maxim5858mru/graduate-work-college-tiu/Altium Designer Project/Source/AMS1117 - 3.3 PCB.jpg

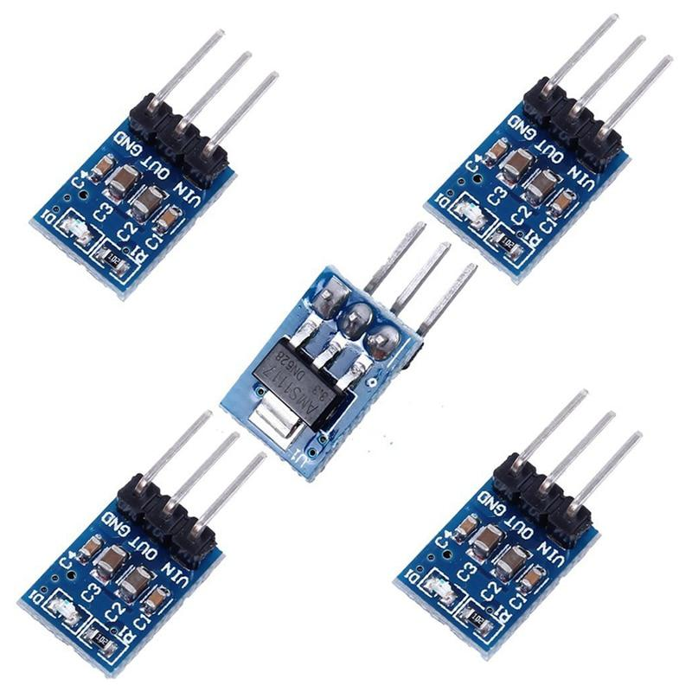
Altium Designer Project/Source/AMS1117 - 3.3 PCB.jpg
