maxim5858mru/graduate-work-college-tiu/Text/Дипломная работа/ГОСТ/2 ГОСТ Р 54831-2011.pdf

ГОСТ Р 54831-2011 (http://GostPDF.ru/gost-54831-2011)
GostPDF.ru

Страница: 1/20

Powered by TCPDF (www.tcpdf.org)
