maxim5858mru/graduate-work-college-tiu/Text/Дипломная работа/Презентация.pptx

## Выпускная квалификационная работа на тему: «Разработка интеллектуальной системы контроля и управления доступом»

Выполнил обучающийся
гр. КСт-16-(9)-2 отд. ИТВТ МПК
Кулаков Максим Иванович
Проверил: руководитель ВКР
Кинчин Евгений Викторович

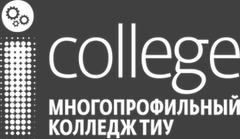
[picture p3: figure]

Notes: Время слайда: 00:13
Текст: Здравствуйте, уважаемая комиссия. Я Кулаков Максим Иванович, студент группы КСт-16-9-2 хочу представить вам свою дипломную работу на тему “Разработка интеллектуальной системы контроля и управления доступом”.

## Актуальность

Появление и внедрение новых технологий

Рост потребности внедрения ограничений доступа

за 2017 год

Активное развитие сферы безопасности

Рост требований

Notes: Время слайда: 00:35 (00:48)
Текст: На данный момент разработка системы контроля и управления доступом является актуальной по ряду причин. Одной из таких причин является развитие и появление новых технологий идентификации пользователей. Кроме этого актуальность разработки повышает активное развитие сферы безопасности. В связи с этим наблюдается рост потребностей и требований к современным системам безопасности. Доказательством актуальности является анализ рынка сферы безопасности за 2017 года , денежный объём которого равен 17 миллиардов рублей, среди которых 20% это стоимость реализованных СКУД.

## Цель

И

Задачи

Анализ документации

Проектирование аппаратной
части

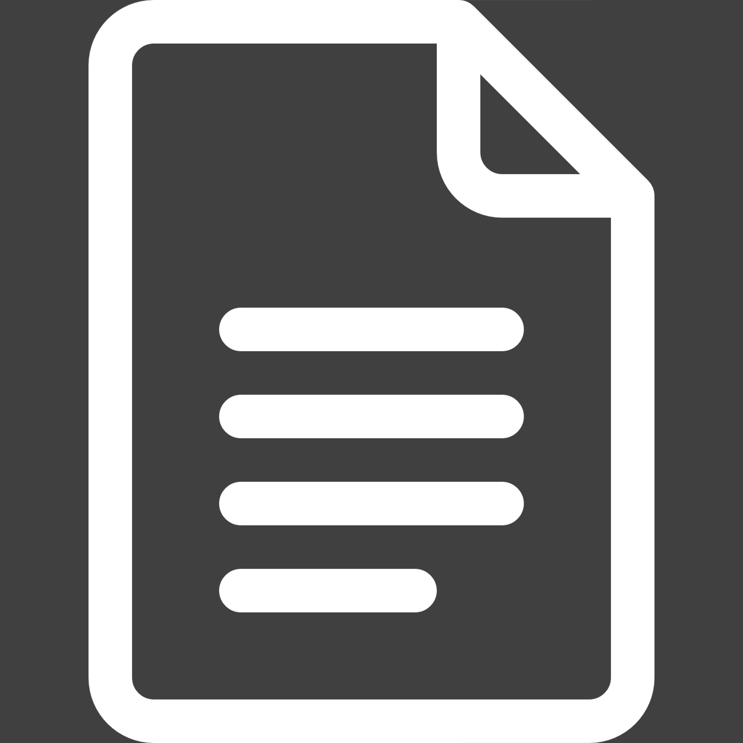
[picture p4: figure]

Разработка
устройства

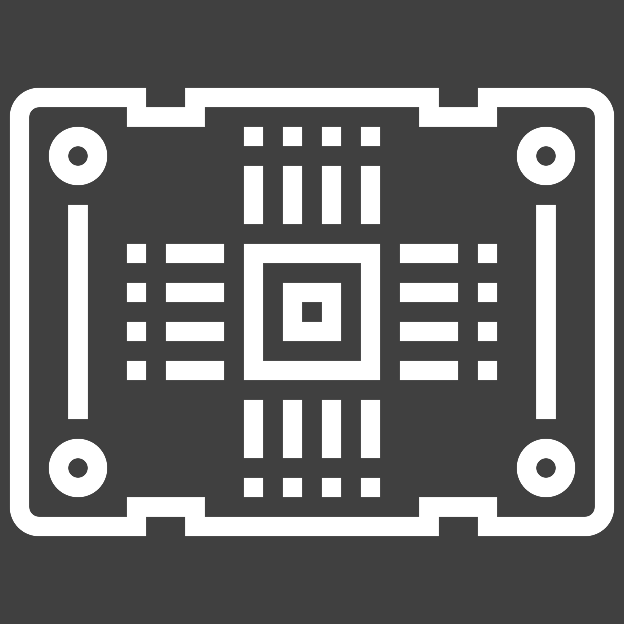
[picture p5: figure]
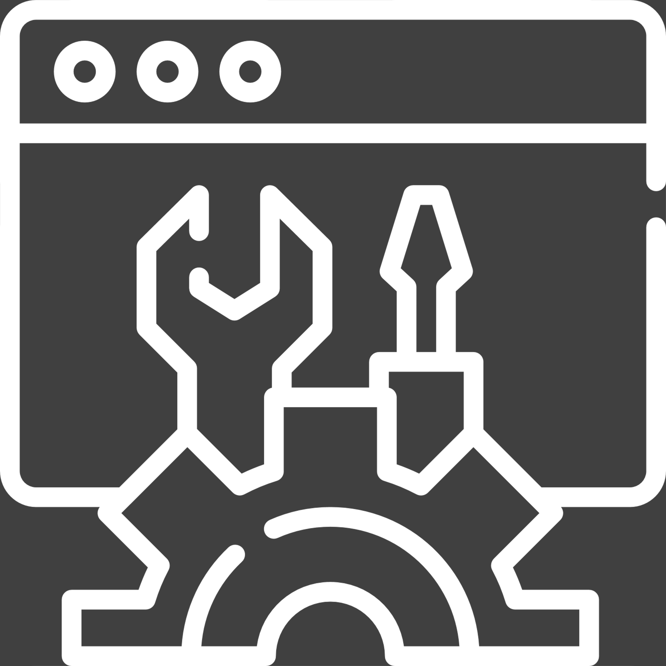
[picture p6: figure]

Разработка программной части

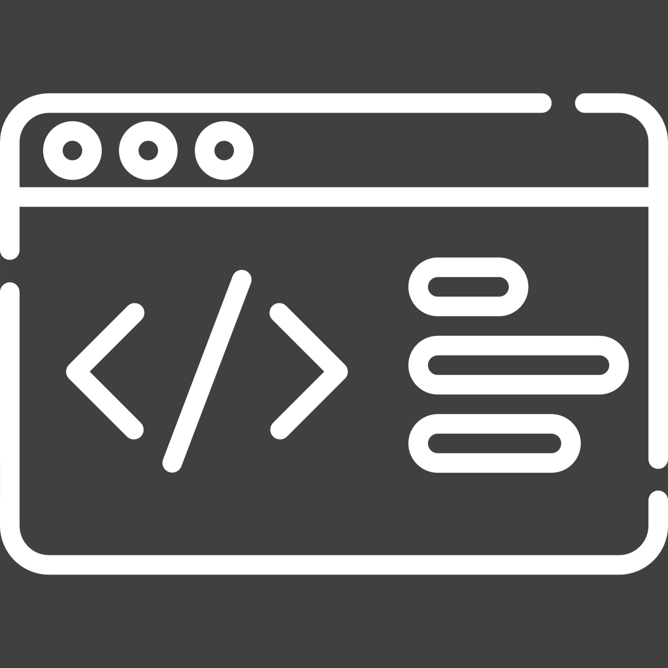
[picture p7: figure]

Оформление документации

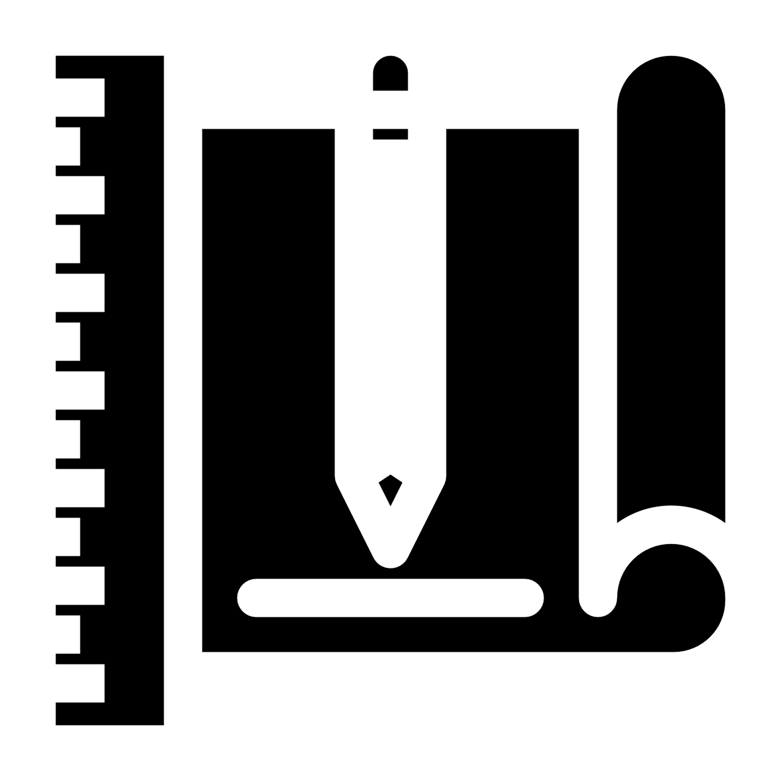
[picture p8: figure]

Notes: Время слайда: 0:18 (01:06)
Текст: Целью работы является разработка устройства. Разработка включает в себя множество этапов. Эти этапы и формируют задачи проекта. Основными задачами проекта является анализ различной документации, разработка аппаратной и программной части и оформление документации в соответствии с ГОСТами.

## Разработка

АППАРАТНОЙ ЧАСТИ

Выбор САПР

Структурная схема

1

Функциональная схема

2

3

Проектирование ППМ

6

Настройка правил

5

Принципиальная схема

4

Notes: Время слайда: 00:18 (01:24)
Текст: Основные этапы разработки аппаратной части указаны на слайде. В основном это выбор и настройка необходимых программных средств, а также разработка ряда схем. Самой главной частью устройства является микроконтроллер ESP32. Также была разработана двухстороння плата печатного монтажа в САПР Altium Designer.

## Разработка

ПРОГРАММНОЙ ЧАСТИ

Конфигурирование
микроконтроллера

1

Выбор IDE

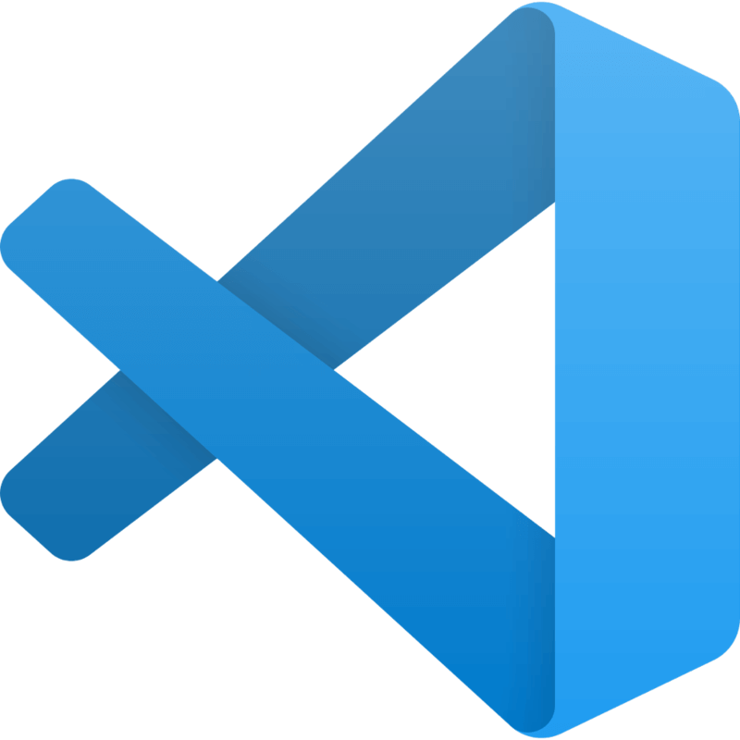
[picture p9: figure]

2

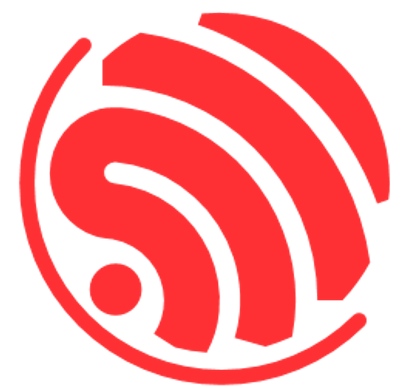
[picture p10: figure]
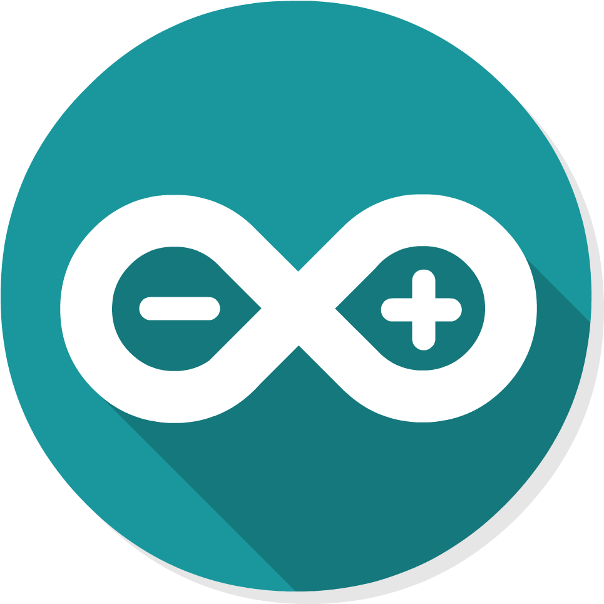
[picture p11: figure]

5

Тестирование

Реализация

4

3

Разработка
алгоритма

Notes: Время слайда: 0:12 (01:36)
Текст: Разработка программной части включает в себя выбор IDE, разработку алгоритма, его реализацию и тестирование. В качестве IDE была выбрана PlatformIO, на основе Visual Studio Code.

## Функционал устройства

Идентификация пользователя

RFID карт

База
данных

Резервный источник питания

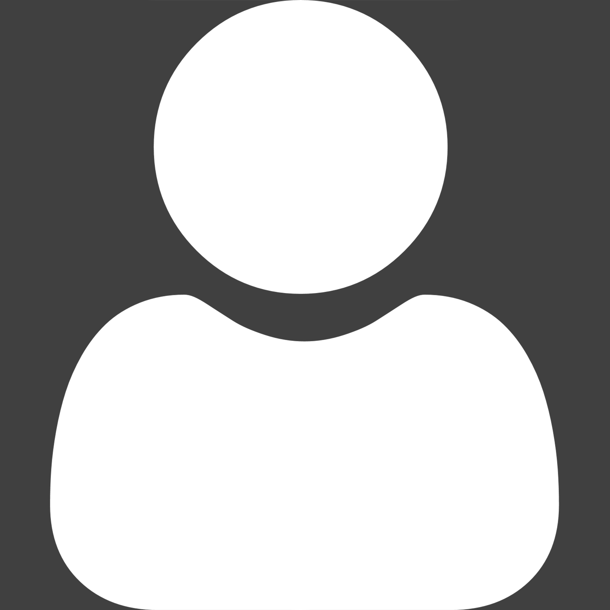
[picture p12: figure]
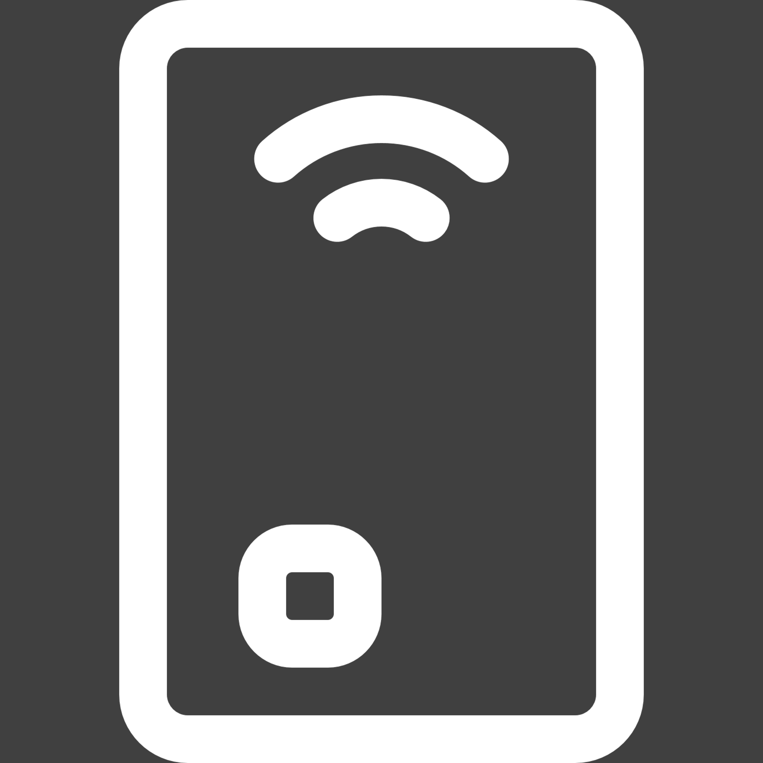
[picture p13: figure]
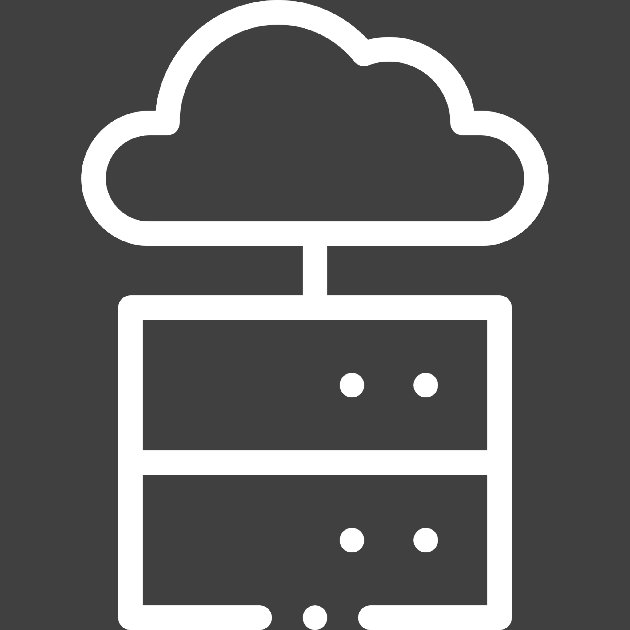
[picture p14: figure]
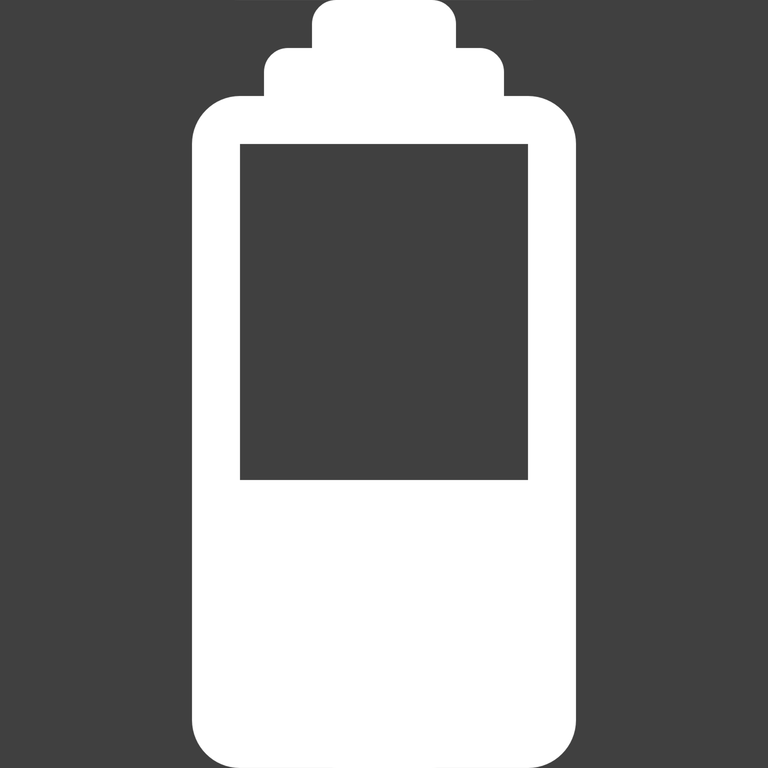
[picture p15: figure]

PIN-код

Сканер
отпечатка пальцев

Web
сервер

Журнал

Notes: Время слайда 0:18 (01:54)
Текст: Основной функцией устройства является идентификация пользователя. Разработанное устройство поддерживает идентификацию по ПИН-коду, RFID карте и с помощью отпечатка пальца. Также устройство имеет базу данных пользователей, журнал авторизаций, веб-итерфейс для управления и резервный источник питания.

## Экономическая эффективность

Срок | Ежемесячное производство | | Предварительное производство
| Тираж при +25% | Тираж при +50% | Тираж при +25% | Тираж при +50%
1 | 87 | 52 | 87 | 52
2 | 44 | 28 | 43 | 26
3 | 33 | 18 | 29 | 17
4 | 24 | 17 | 22 | 13
5 | 20 | 13 | 17 | 10
6 | 23 | 11 | 14 | 9
7 | 20 | 9 | 12 | 7
8 | 17 | 8 | 11 | 7
9 | 15 | 9 | 10 | 6
10 | 14 | 8 | 9 | 5
11 | 12 | 10 | 8 | 5
12 | 11 | 9 | 7 | 4

Notes: Время слайда: 0:27 (02:21)
Текст: По окончанию разработки был рассчитан минимальный необходимый тираж и срок окупаемости. Себестоимость устройства равна 3 100 ₽. Было рассчитано 4 возможных способа реализации: при ежемесячном производстве с наценкой +25% и +50%, а также при предварительном полном производстве с наценкой +25% и +50%. Результаты расчётов показаны на слайде.

## Работа устройства

Notes: Время слайда: 00:13 (02:34)
Текст: Теперь я хочу показать вам видео демонстрации работы устройства. Из-за ситуации с короновирусом не получилось собрать печатную плату, поэтому в демонстрации используется полностью рабочий прототип на беспаечной макетной плате.

[НАЧАЛО ВИДЕО]
Разработанное устройство может работать, как от аккумулятора , так и от зарядного устройства. [02:40]
При запуске устройство выполняет самодиагностику. Результат выводится на дисплей [02:45]
Как говорилось ранее устройство поддерживает 3 способа авторизации: с помощью отпечатка пальцев, карты RFID и ПИН кода. Для одного пользователя можно выбрать несколько способов авторизации. После успешной авторизации выводится звуковое и графическое уведомление. [03:04]
[ПОТЕРЯ ВРЕМЕНИ] [03:08]
Также устройство поддерживает ограничение по временному промежутку. При желании для пользователь можно выбрать и один способ авторизации. Устройство поддерживает 2 замка, номер открываемого замка задаётся в базе данных. [03:24]
Устройству без разницы какой первичный способ авторизации выберет пользователь. Если пользователь не будет идентифицирован по одному из необходимых методов, будет выведена ошибка. Кроме этого устройство имеет кнопку для открытия двери. [04:00]

[ДЕМОНСТРАЦИЯ ВЕБ-СЕРВЕРА]
Как упоминалось ранее устройство поддерживает веб-сервер для управления. С его помощью можно посмотреть конфигурацию и состояние устройства, выполнить добавление, удаление и изменение пользователей, а также просмотреть журнал записей и изменить конфигурацию устройства.

## Спасибо за внимание!

Notes: В заключении хотелось бы сказать что цель достигнута и все поставленные задачи выполнены. Результатом работы является разработанное устройство.
