maxim5858mru/graduate-work-college-tiu/Text/Дипломная работа/Подтверждение.pdf

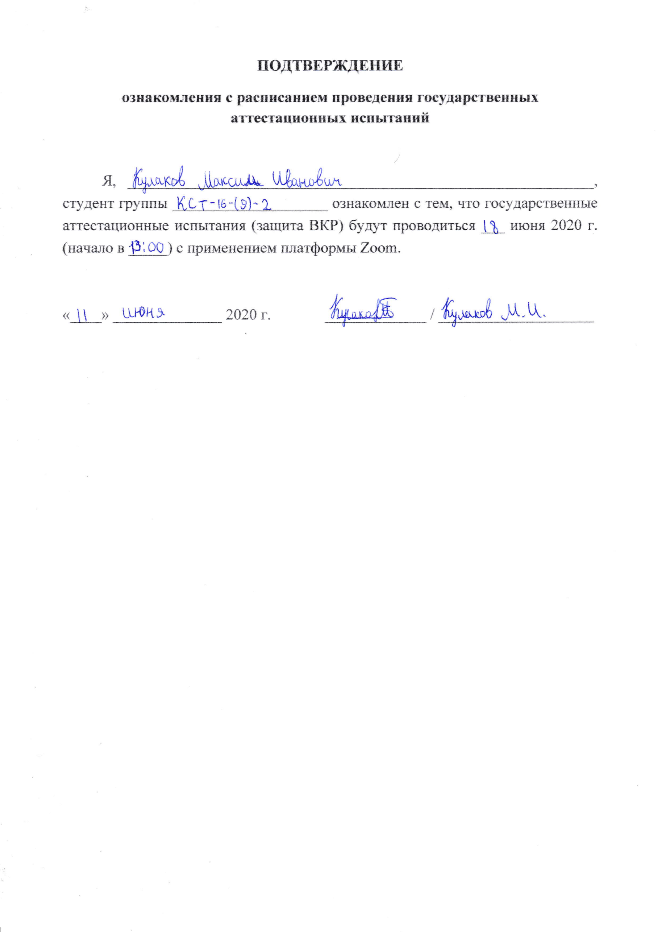
[picture p24: page 1]

жi}дТ'ВЕР/*{дЕНl{Е

t}знакомлаЕия ý $}8gýи*ан Еем IIров8д8ния гO₠удар*твеЕýых ftyтеетаци{}нýых исп ыта кнfi

я,
студент груilпы Кст
| - tб -[9) -)_ | 0знакOмл9tr{ с тýм, что гоýударственные
аттестацЕонные иýilытаýЕя {защита ВКР} будrг шровод,rтъýя lЪ июЕя 2а2а r. (начало в ФlO0 } с црименеýшgм гrлаформы Zooяl.
n-Il-n LIJo,,t9, | 2020 r. | t#,Б / fуд-,8 Л.Ц.
