maxim5858mru/graduate-work-college-tiu/Text/Дипломная работа/Согласие.pdf

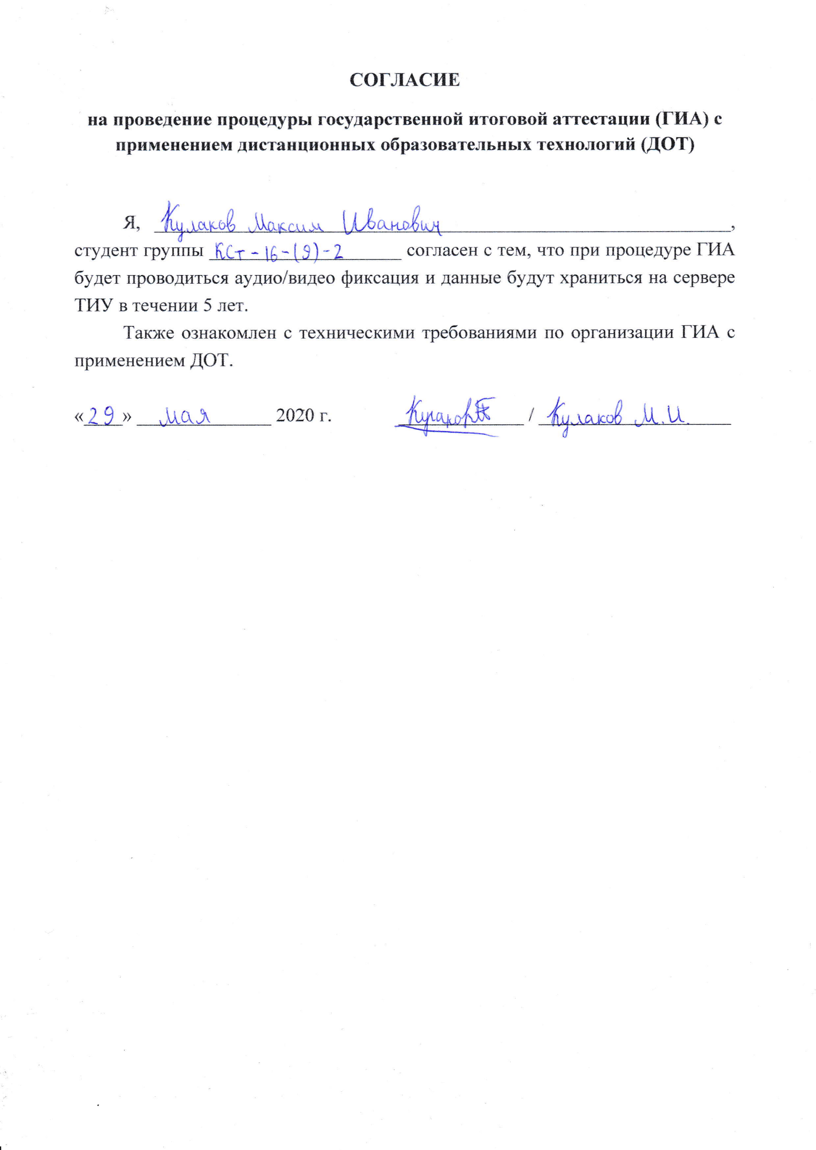
[picture p25: page 1]

### ссгллсиý

на провsденЕе проl{едуры го₠.]/дарственшOй итоговой аттестацI!и {ГИА} шримененрiем дистаЕцItонЕых обр*зовательных технолсгий {ДОТ}

я,
студент групшы | | | согласен с тем, что при процедуре ГИА
будет шроводитъся аудиоlвидео фиксация и даt{Еыý буду, хранитъся на сервере
ТиУвтечении5лет.
Также ознакOллпен с техническими требоватrиями по организации ГИА применением ýОТ.
n2L> ,Itц-\ | 1n]n ,- L\J-\j | l, | 4щЩ-l 4.,"J-'l,.u
