maxim5858mru/graduate-work-college-tiu/Altium Designer Project/Source/AMS1117 - 3.3 №1.jpg

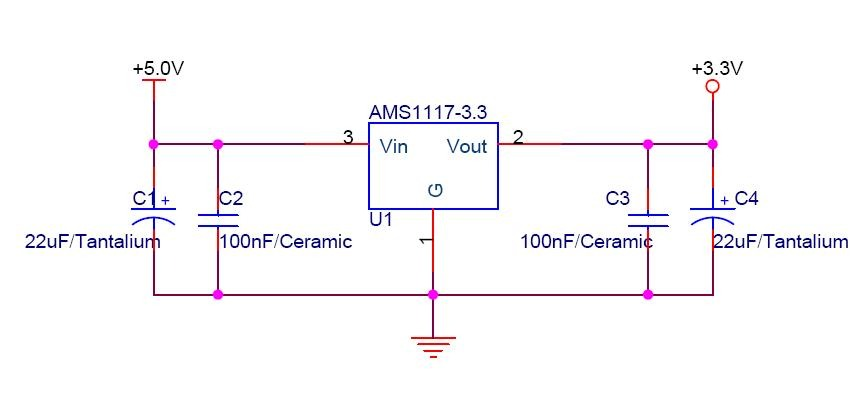
Altium Designer Project/Source/AMS1117 - 3.3 №1.jpg
