maxim5858mru/graduate-work-college-tiu/Altium Designer Project/Source/BAT - MT3608.jpg

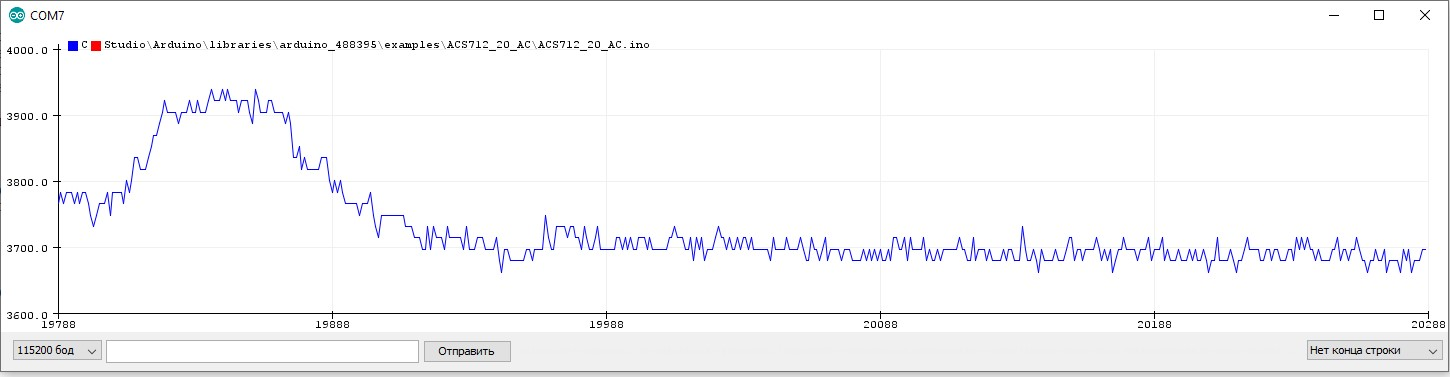
Altium Designer Project/Source/BAT - MT3608.jpg
