maxim5858mru/graduate-work-college-tiu/Altium Designer Project/Source/CH340G (NodeMCU ESP32).png

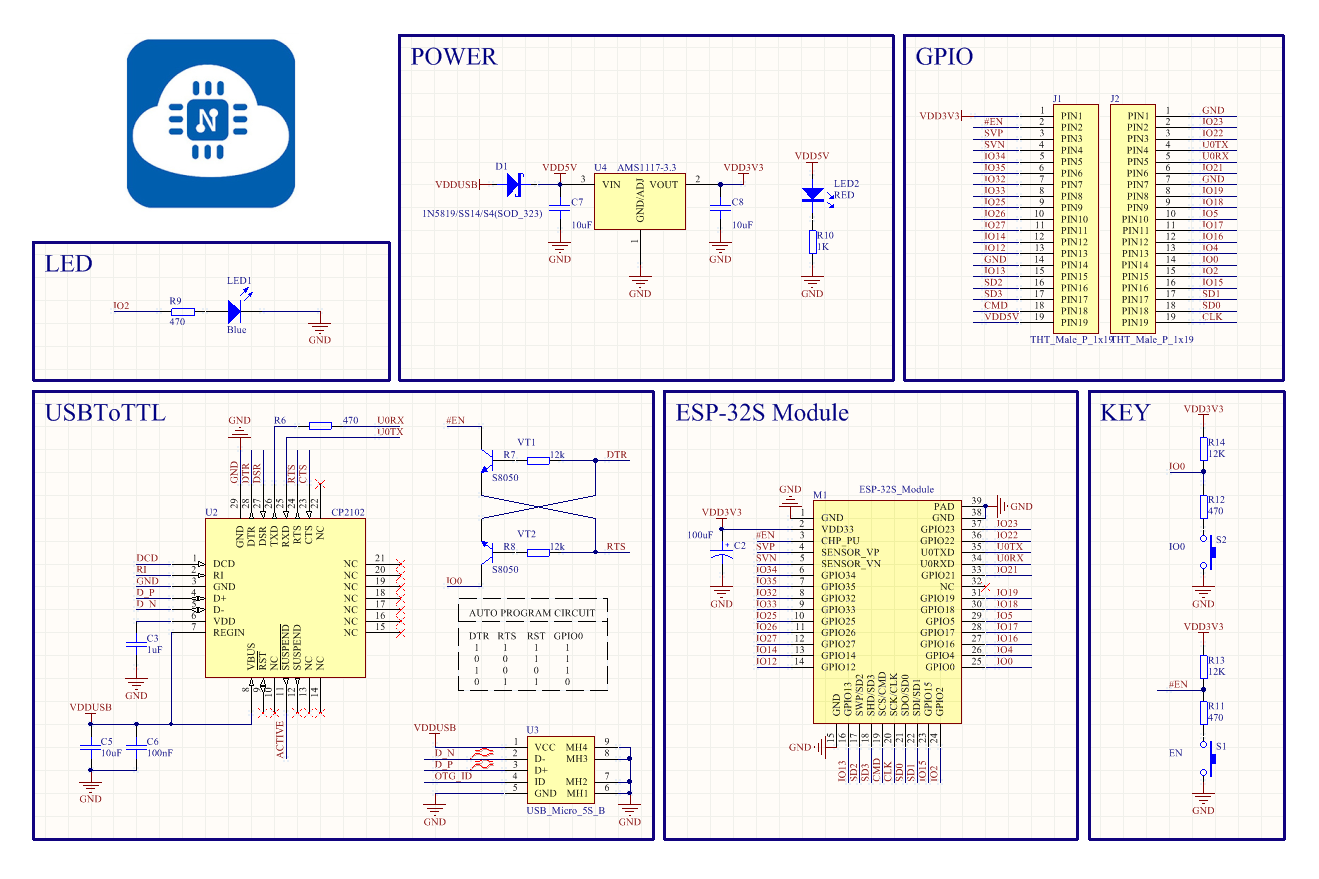
Altium Designer Project/Source/CH340G (NodeMCU ESP32).png
