maxim5858mru/graduate-work-college-tiu/Altium Designer Project/Source/CH340G №2.png

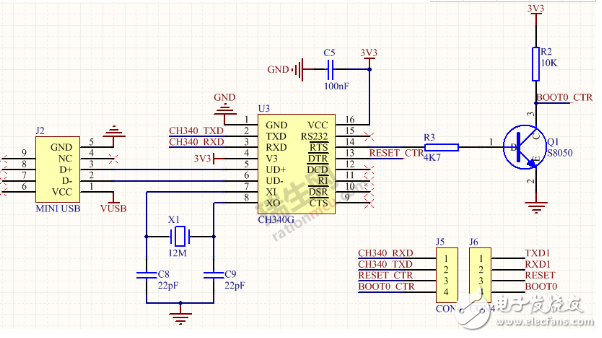
Altium Designer Project/Source/CH340G №2.png
