maxim5858mru/graduate-work-college-tiu/Altium Designer Project/Source/ESP32 Pinout.png

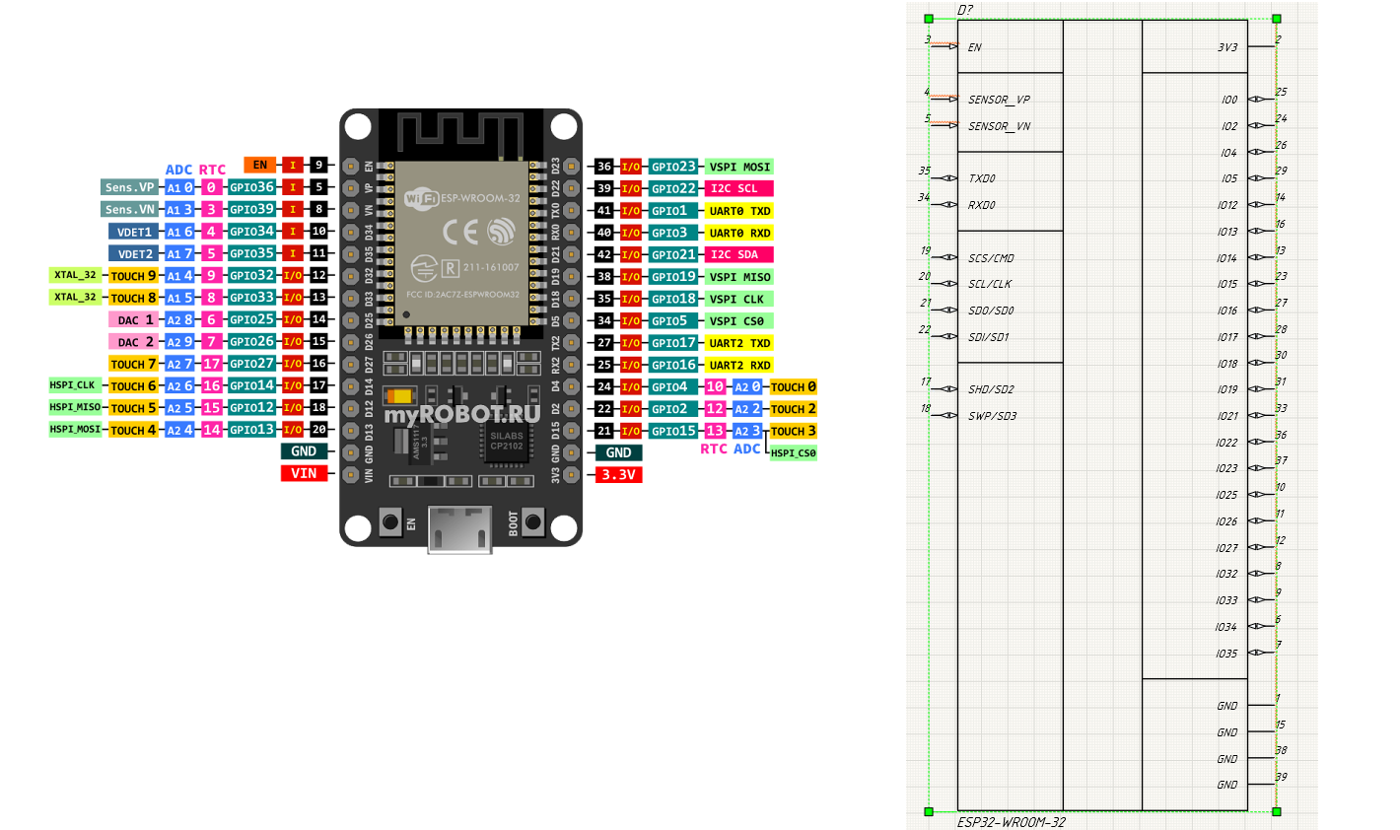
Altium Designer Project/Source/ESP32 Pinout.png
