maxim5858mru/graduate-work-college-tiu/Altium Designer Project/Source/ESP32-DevKit v1.jpg

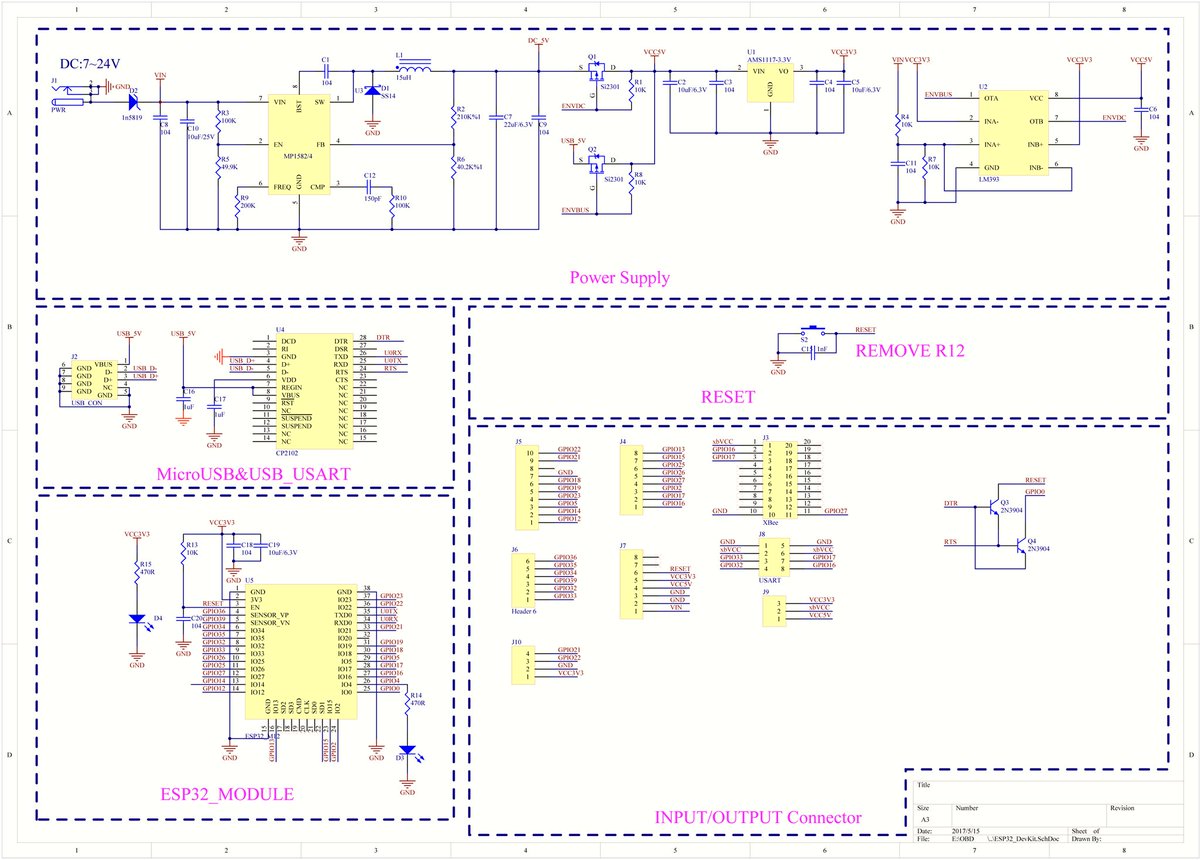
Altium Designer Project/Source/ESP32-DevKit v1.jpg
