maxim5858mru/graduate-work-college-tiu/Altium Designer Project/Source/Logic Levels.png

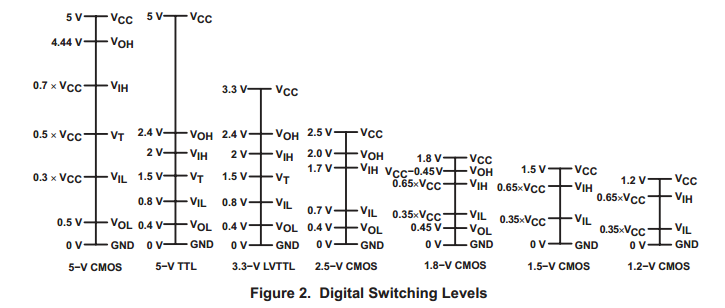
Altium Designer Project/Source/Logic Levels.png
