maxim5858mru/graduate-work-college-tiu/Altium Designer Project/Source/SD Pinout.png

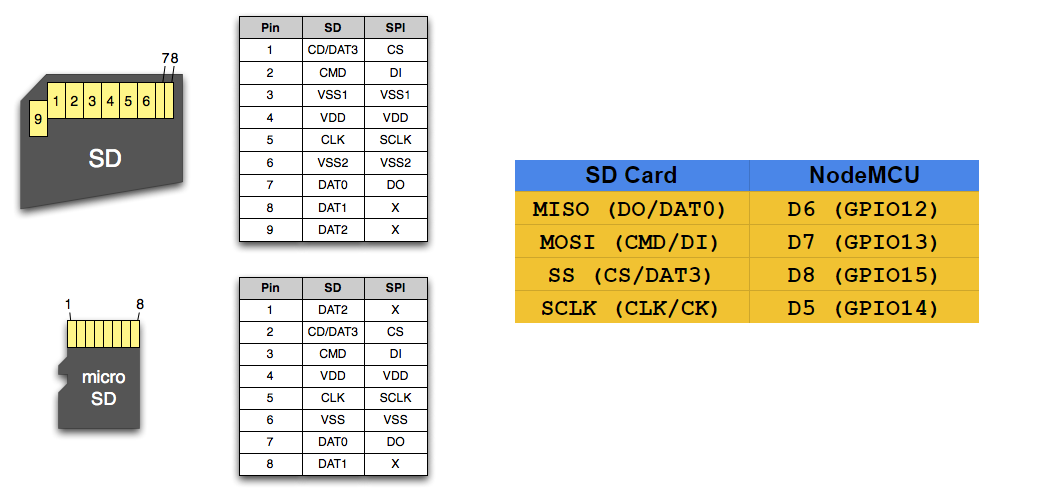
Altium Designer Project/Source/SD Pinout.png
