maxim5858mru/graduate-work-college-tiu/Altium Designer Project/Source/TP4056 №1.png

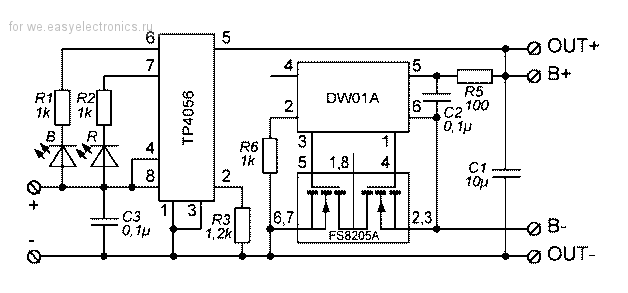
Altium Designer Project/Source/TP4056 №1.png
