maxim5858mru/graduate-work-college-tiu/Altium Designer Project/Source/TP4056 №2.webp

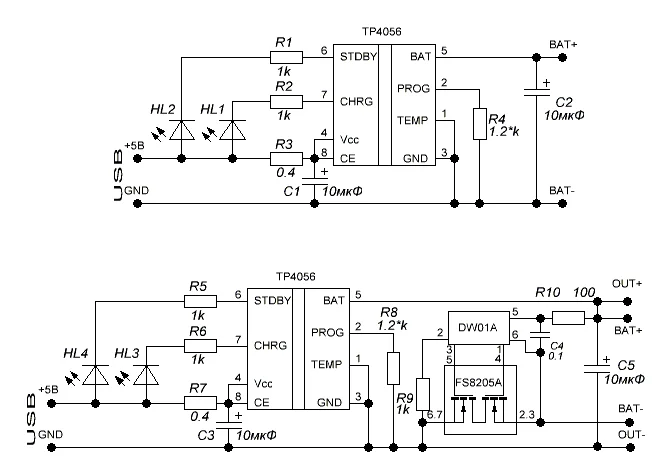
Altium Designer Project/Source/TP4056 №2.webp
