maxim5858mru/graduate-work-college-tiu/Altium Designer Project/Source/TP4056 №3.jpg

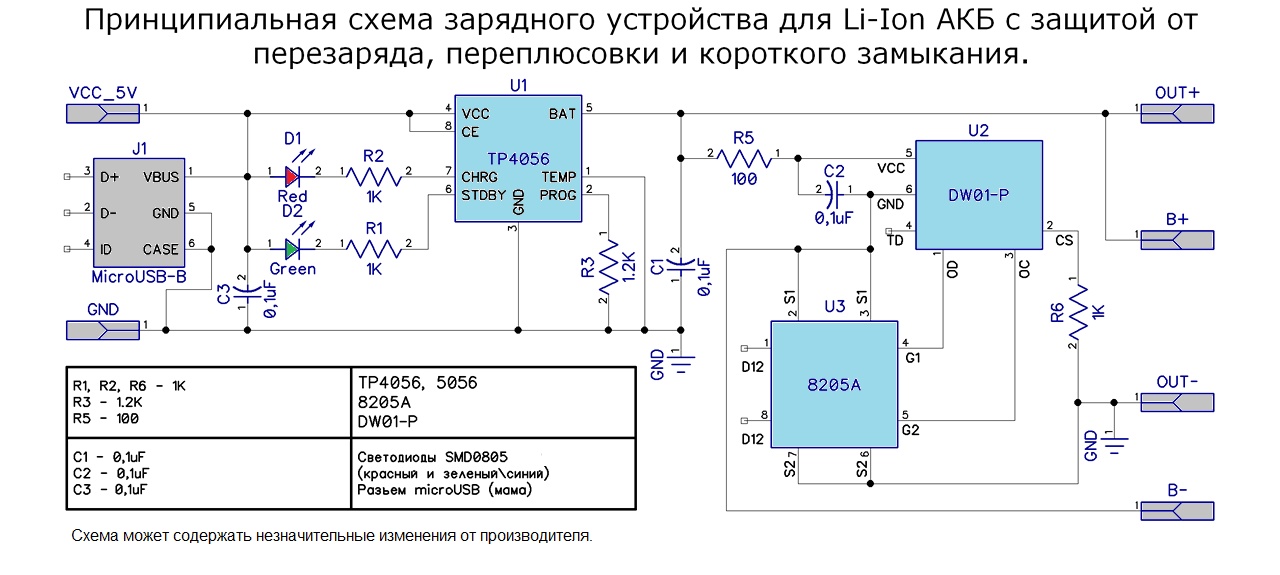
Altium Designer Project/Source/TP4056 №3.jpg
