maxim5858mru/graduate-work-college-tiu/Altium Designer Project/Source/Преобразователь уровня.jpg

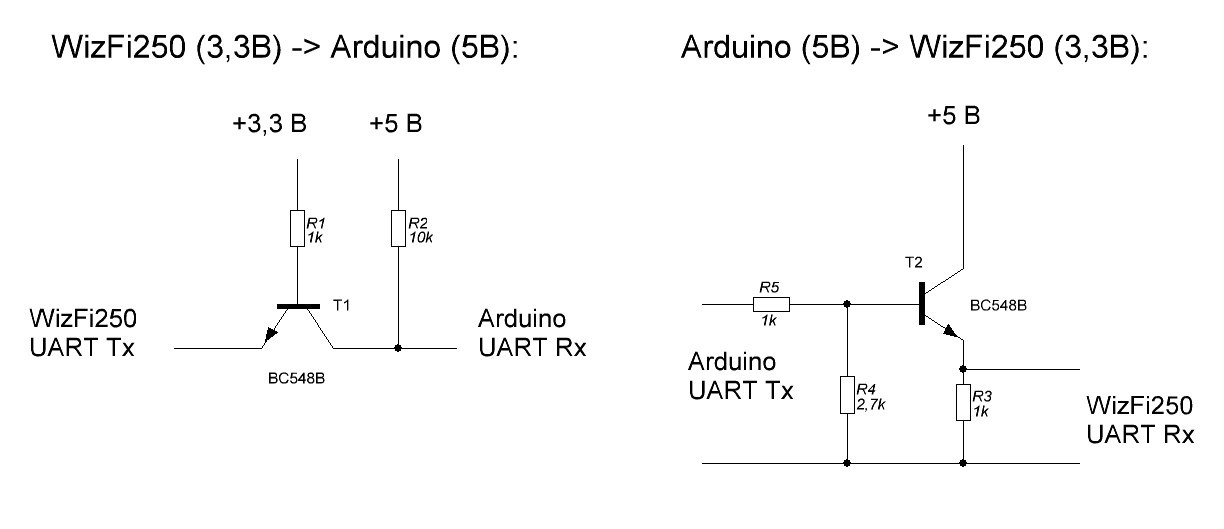
Altium Designer Project/Source/Преобразователь уровня.jpg
