maxim5858mru/graduate-work-college-tiu/Altium Designer Project/Project Outputs for Graduate Work/BOM/Bill of Materials-Graduate Work.xlsx

D1 | SOP-8 | TP4056E | NanJing Top Power ASIC Corp. | TP4056E | 1
D2 | SOT-23-6 | DW01A | Shenzhen H&M Semiconductor Co. Ltd. | DW01A | 1
D3 | SOT-23-6 | MT3608 | AEROSEMI | MT3608 | 1
D4 | SOT-223 | AMS1117-3.3 | Advanced Monolithic Systems | AMS1117-3.3 | 1
D5 |  | DS1307 | Dallas Semiconductor | DS1307 | 1
D6 |  | ESP32-WROOM-32 | Espressif Systems | ESP32-WROOM-32 | 1
Designator | Case | Comment | Manufacturer | Model | Quantity
DS1 | PDIP-8 | AT24C512PI27 | Atmel | AT24C512PI27 | 1
GB1 | 18650 | 3.6V | LG | LGAAS31865 | 1
GB2 | CR2032 | 3.3V |  |  | 1
HA1 |  | TMB12A05 |  | TMB12A05 | 1
HG1 |  | LCD1602 |  | LCD1602 | 1
HL1 | 0805 | LED-Red | Taiwan Oasis Technology Co., Ltd | LED-Red | 1
HL2 | 0805 | LED-Green | Taiwan Oasis Technology Co., Ltd | LED-Green | 1
HL4 | 0805 | LED-Yellow | Taiwan Oasis Technology Co., Ltd | LED-Yellow | 1
HL5 | 0805 | LED-Blue | Taiwan Oasis Technology Co., Ltd | LED-Blue | 1
J1 |  | =Valuemanufacturerpartnumber |  |  | 1
K1, K2 |  | SRA-05VDC-CL | Ningbo Songle | SRA-05VDC-CL | 2
L1 | SMD D10xH4.8 | 22µH | Epcos | B82464G4223M | 1
R1, R2, R4, R17, R20, R21 | 0805 | 1k |  | RC0805JR-071KL, RC0805FR-071KL | 6
R10, R11, R13, R14 | 0805 | 12k |  | RC0805FR-0712KL | 4 | 16 | 0603
R16 | 0805 | 10k |  | RC0805FR-0710KL | 1
R18 | 0805 | 2k |  | RC0805JR-072KL | 1
R19 | 0805 | 3k |  | RC0805JR-073KL | 1
R22, R23 | 0805 | 240 |  | RC0805JR-07240RL | 2
R24, R25, R26 | 0805 | 4,7k |  | RC0805FR-074K7L | 3
R3 | 0805 | 1.2k |  | RC0805FR-071K2L | 1 | 19
R5 | 0805 | 100 |  | RC0805FR-07100RL | 1
R6 | 2512 | 15k |  | RC2512FR-0715KL | 1 | 9
R7 | 2512 | 110k |  | RC2512FR-07110KL | 1 | 9 | 1206
R8, R9, R12, R15 | 0805 | 470 |  | RC0805FR-07470RL | 4
RP1 |  | 10k |  |  | 1
SB1, SB2 |  | TS3601 | KLS electronic co ltd | TS3601 | 2
SB3 |  | Матричная Клавиатура 4x4 |  |  | 1
SB4 |  | "Дверь №1" |  |  | 1
SB5 |  | "Дверь №2" |  |  | 1
U1 | SOP-16 | CH340G | Nanjing Qinheng Microelectronics Co. Ltd. | CH340G | 1
U2, U3 |  | PCF8574P |  | PCF8574P | 2
VD1 | SMC | SS34 | Vishay General Semiconductor | SS34 | 1
VD2, VD3 | SMA | SMA4007 |  | SMA4007 | 2
VT1 | TSSOP-8 | FS8205A | Fortune Semiconductor Corp. | FS8205A | 1
VT2, VT3, VT4, VT5, VT6, VT7 | SOT-23-3 | SS8050 | Hottech | SS8050 | 6 |  | KTC8050S
X1 |  | USBB-1J | Molex | USBB-1J | 1
X2 |  | PLS-6 | Connfly | PLS-6 | 1
X3 |  | PLS-4 | Connfly | PLS-4 | 1
X4, X5 |  | 306-031-12 |  | 306-031-12 | 2
X6 |  | Connector, 2pin, 2.54mm, 500VAC, 3A | Connfly |  | 1
X7 |  | PLS-8 |  | PLS-8 | 1
XS1 |  | microSD | Molex |  | 1
Z1 |  | 12MHz |  | HC-49 | 1
Z2 |  | 32.768kHz |  |  | 1
С1, С2, С6, С9 | 0805 | 0.1µF |  | MLCC0.1uFY5V50V+80-20%0805 | 4
С10, С12 | 0805 | 100nF | Murata Manufacturing | GRM21BR71E104KA01L | 2 | 8
С13, С14 | 0805 | 22pF |  | MLCC22pFNPO50V5%0805 | 2
С3, С7, С8, С11 | 0805 | 10µF | Murata Manufacturing | GRM21BR61C106KE15L | 4
С4, С5 | 1206 | 22µF | Murata Manufacturing | GRM31CR61C226KE15L | 2 | 8
