maxim5858mru/graduate-work-college-tiu/Text/Дипломная работа/Части диплома/Расчёт экономической эффективности.xlsx

Sheet: Стоимость
Элемент | Кол-во | Стоимость 1 ед.(₽) | Общая стоимость(₽) | Ссылка
Элементы основной схемы
Микроконтроллер ESP-WROOM-32 | 1 | 146.16 ₽ | 146.16 ₽ | https://aliexpress.ru/item/32808772590.html
Стабилизатор напряжения AMS1117-3.3 | 1 | 1.36 ₽ | 1.36 ₽ | https://aliexpress.ru/item/32944301946.html?s=p&ad_pvid=202005230638154718294210068700003574288_1
EEPROM память AT24C512PI27 | 1 | 20.47 ₽ | 20.47 ₽ | https://aliexpress.ru/item/32598383117.html
Преобразователь USB-UART CH340G | 1 | 20.02 ₽ | 20.02 ₽ | https://aliexpress.ru/item/32838124744.html?s=p&ad_pvid=20200523064316180571280072800003579506_1
Часы реального времени DS1307 | 1 | 6.36 ₽ | 6.36 ₽ | https://aliexpress.ru/item/32845580765.html?s=p&ad_pvid=202005230644098565090043919200003580852_2
Защита аккумулятора DW01A | 1 | 2.38 ₽ | 2.38 ₽ | https://aliexpress.ru/item/32948091423.html?s=p&ad_pvid=20200523064510392996251806300003581539_5
Массив транзисторов FS8205A | 1 | 1.97 ₽ | 1.97 ₽ | https://aliexpress.ru/item/4000367473737.html
Преобразователь IIC PCF8574P | 2 | 21.05 ₽ | 42.10 ₽ | https://aliexpress.ru/item/4000907210022.html?s=p&ad_pvid=202005230647569781299129252420003583276_8
Контроллер зарядки TP4056E | 1 | 3.51 ₽ | 3.51 ₽ | https://aliexpress.ru/item/33048896682.html?s=p
Повышающий преобразователь MT3608 | 1 | 3.76 ₽ | 3.76 ₽ | https://aliexpress.ru/item/32874808297.html?s=p&ad_pvid=202005230650331235533996492640003578726_4
Разъём USB-B | 1 | 9.43 ₽ | 9.43 ₽ | https://aliexpress.ru/item/33043107098.html
Разъём microSD | 1 | 4.97 ₽ | 4.97 ₽ | https://aliexpress.ru/item/32802051702.html?spm=a2g0s.9042311.0.0.1f0f33edeNwXvx
Винтовой разъём 3x 306-031-12 | 4 | 19.00 ₽ | 76.00 ₽ | https://www.chipdip.ru/product/306-031-12
Светодиод TO-2013BC-PG | 1 | 8.00 ₽ | 8.00 ₽ | https://www.chipdip.ru/product/to-2013bc-pg
Светодиод TO-2013BC-MRE | 1 | 6.00 ₽ | 6.00 ₽ | https://www.chipdip.ru/product/to-2013bc-mre
Светодиод TO-2013BC-MYF | 1 | 8.00 ₽ | 8.00 ₽ | https://www.chipdip.ru/product/to-2013bc-myf
Светодиод TO-2013BC-BF | 1 | 7.00 ₽ | 7.00 ₽ | https://www.chipdip.ru/product/to-2013bc-bf
Подстрочный резистор 3296X | 1 | 24.00 ₽ | 24.00 ₽
Резистор 4,7k SMD 0805 | 3 | 0.04 ₽ | 0.12 ₽ | https://aliexpress.ru/item/32871123420.html
Резистор 240 SMD 0805 | 2 | 0.56 ₽ | 1.11 ₽ | https://aliexpress.ru/item/32871123420.html
Резистор 3k SMD 0805 | 1 | 0.56 ₽ | 0.56 ₽ | https://aliexpress.ru/item/32871123420.html
Резистор 2k SMD 0805 | 1 | 0.56 ₽ | 0.56 ₽ | https://aliexpress.ru/item/32871123420.html
Резистор 10k SMD 0805 | 1 | 0.56 ₽ | 0.56 ₽ | https://aliexpress.ru/item/32871123420.html
Резистор 12k SMD 0805 | 4 | 0.56 ₽ | 2.22 ₽ | https://aliexpress.ru/item/32871123420.html
Резистор 470 SMD 0805 | 4 | 0.56 ₽ | 2.22 ₽ | https://aliexpress.ru/item/32871123420.html
Резистор 1,2k SMD 0805 | 1 | 0.56 ₽ | 0.56 ₽ | https://aliexpress.ru/item/32871123420.html
Резистор 1k SMD 0805 | 6 | 0.56 ₽ | 3.33 ₽ | https://aliexpress.ru/item/32871123420.html
Резистор 100 SMD 0805 | 1 | 0.56 ₽ | 0.56 ₽ | https://aliexpress.ru/item/32871123420.html
Резистор 15k SMD 2512 | 1 | 4.36 ₽ | 4.36 ₽ | https://aliexpress.ru/item/32829517578.html
Резистор 110k SMD 2512 | 1 | 4.36 ₽ | 4.36 ₽ | https://aliexpress.ru/item/32829517578.html
Конденсатор 22pF SMD 0805 | 2 | 0.70 ₽ | 1.40 ₽ | https://aliexpress.ru/item/32964553793.html
Конденсатор 100nF SMD 0805 | 2 | 0.70 ₽ | 1.40 ₽ | https://aliexpress.ru/item/32964553793.html
Конденсатор 22µF SMD 1206 | 2 | 1.45 ₽ | 2.91 ₽ | https://aliexpress.ru/item/33016966236.html
Конденсатор 10µF SMD 0805 | 4 | 0.91 ₽ | 3.62 ₽ | https://aliexpress.ru/item/32964553793.html
Конденсатор 0.1µF SMD 0805 | 4 | 0.97 ₽ | 3.89 ₽ | https://aliexpress.ru/item/32903313311.html?s=p&ad_pvid=20200524064533383388000592670004654046_1
Диод SS34 | 1 | 0.50 ₽ | 0.50 ₽ | https://aliexpress.ru/item/33048439713.html?s=p&ad_pvid=202005240032014591868125946460004349620_1
Диод SMA4007 | 2 | 0.54 ₽ | 1.09 ₽ | https://aliexpress.ru/item/32826666254.html
Транзистор SOT-23 SS8050 | 6 | 0.60 ₽ | 3.60 ₽ | https://aliexpress.ru/item/32873227586.html?s=p&ad_pvid=202005240035048508726070138800004354392_3
Катушка индуктивности B82464G4223M | 1 | 120.00 ₽ | 120.00 ₽ | https://www.chipdip.ru/product/b82464g4223m
Отсек для аккумулятора 18650 | 1 | 50.43 ₽ | 50.43 ₽ | https://aliexpress.ru/item/33037738446.html
Отсек для батарейки CR2025 | 1 | 29.24 ₽ | 29.24 ₽ | https://aliexpress.ru/item/32949445306.html
Кварцевый резонатор 12 МГц | 1 | 5.48 ₽ | 5.48 ₽ | https://aliexpress.ru/item/32905911610.html?spm=a2g0s.9042311.0.0.1f0f33edeNwXvx
Кварцевый резонатор 32.768 кГц | 1 | 5.48 ₽ | 5.48 ₽ | https://aliexpress.ru/item/32905911610.html?spm=a2g0s.9042311.0.0.1f0f33edeNwXvx
Пьезодинамик TMB12A05 | 1 | 10.38 ₽ | 10.38 ₽ | https://aliexpress.ru/item/33050533308.html?s=p&ad_pvid=20200524003101633931875486150002254226_1
Реле SRA-05VDC | 2 | 25.58 ₽ | 51.16 ₽ | https://aliexpress.ru/item/32836198919.html?spm=a2g0s.9042311.0.0.1f0f33edeNwXvx
Кнопка тактовая TS3601 | 2 | 0.44 ₽ | 0.88 ₽ | https://aliexpress.ru/item/4000030081332.html
PBS-16 | 1 | 12.00 ₽ | 12.00 ₽ | https://www.chipdip.ru/product/pbs16
PLS-8 | 1 | 1.08 ₽ | 1.08 ₽ | https://aliexpress.ru/item/32878293371.html?spm=a2g0s.9042311.0.0.264d33edbISUGp
PLS-6 | 2 | 0.81 ₽ | 1.62 ₽ | https://aliexpress.ru/item/32878293371.html?spm=a2g0s.9042311.0.0.264d33edbISUGp
PLS-4 | 1 | 0.54 ₽ | 0.54 ₽ | https://aliexpress.ru/item/32878293371.html?spm=a2g0s.9042311.0.0.264d33edbISUGp
PLS-2 | 2 | 0.27 ₽ | 0.54 ₽ | https://aliexpress.ru/item/32878293371.html?spm=a2g0s.9042311.0.0.264d33edbISUGp
Перемычка 2x2,54 мм | 1 | 0.71 ₽ | 0.71 ₽ | https://aliexpress.ru/item/33038600944.html?s=p&ad_pvid=202005240721153859348858914580004687806_2
SCS-16 | 2 | 8.00 ₽ | 16.00 ₽ | https://www.chipdip.ru/product/scs-16
SCS-8 | 2 | 8.00 ₽ | 16.00 ₽ | https://www.chipdip.ru/product/scs-8
Ультразвуковой датчик расстояния HC-SR04 | 1 | 50.43 ₽ | 50.43 ₽ | https://aliexpress.ru/item/1806565095.html
Сканер отпечатков пальцев FPM10A | 1 | 401.19 ₽ | 401.19 ₽ | https://aliexpress.ru/item/32982364002.html?spm=a2g0s.9042311.0.0.5d5533edYt1y0S
Мембранная клавиатура 4x4 | 1 | 46.77 ₽ | 46.77 ₽ | https://aliexpress.ru/item/32874565775.html?spm=a2g0s.9042311.0.0.264d33edM25y4h
Считыватель RFID меток MFRC-522 | 1 | 102.31 ₽ | 102.31 ₽ | https://aliexpress.ru/item/33014153324.html?spm=a2g0s.9042311.0.0.264d33ed75WfzP
Дисплей LCD1602 | 1 | 97.20 ₽ | 97.20 ₽ | https://aliexpress.ru/item/32897651120.html?s=p&ad_pvid=20200524071153935045963939430004676651_1
Батарейка CR2025 | 1 | 18.42 ₽ | 18.42 ₽ | https://aliexpress.ru/item/4000389879469.html?s=p
Аккумулятор LGAAS31865 | 1 | 132.27 ₽ | 132.27 ₽ | https://aliexpress.ru/item/4000924304797.html?s=p&ad_pvid=20200524071024927259689806100004682763_7
Корпус 197x113x63 мм | 1 | 360.00 ₽ | 360.00 ₽
Карта памяти microSD 1Gb | 1 | 159.60 ₽ | 159.60 ₽ | https://aliexpress.ru/item/33019390820.html
Элементы необходимые для разработки
Провода Dupont M-M 10 см. | 80 | 1.26 ₽ | 100.86 ₽
Платформа для разработки ESP32 DevKit | 1 | 261.62 ₽ | 261.62 ₽
Макетная плата MB-102 | 2 | 138.85 ₽ | 277.70 ₽
Модуль TP4056 | 1 | 18.56 ₽ | 18.56 ₽
Модуль MT3608 | 1 | 29.24 ₽ | 29.24 ₽
IIC модуль для LCD | 1 | 58.47 ₽ | 58.47 ₽
Кнопка тактовая 6x6 | 2 | 5.48 ₽ | 10.96 ₽
Адпатер microSD | 1 | 44.72 ₽ | 44.72 ₽
Транзистор TO-92 SS8050 | 3 | 0.77 ₽ | 2.32 ₽
Припой CF-10 63/37 0,8 мм | 1 | 340.00 ₽ | 340.00 ₽
Флюс Solins ЛТИ-120 100 мл | 1 | 130.00 ₽ | 130.00 ₽
Общая стоимость элементов основной схемы: |  |  | 2120.12 ₽
Общая стоимость элементов для разработки: |  |  | 1274.46 ₽
Итог: |  |  | 3394.58 ₽

Sheet: Трудоёмкость
Вид работ | Кол-во дней | Кол-во часов
Разработка технического задания | 10 | 40
Изучение существующих аналогов | 5 | 20
Разработка структурной схемы | 2 | 8
Разработка функциональной схемы | 1 | 4
Разработка принципиальной схемы | 4 | 16
Анализ принципиальной схемы | 3 | 12
Выполнение трассировки ППМ | 4 | 16
Разработка программного обеспечения МК | 15 | 60
Тестирование программного обеспечения | 5 | 20
Сборка образца устройства | 1 | 4
Расчёт экономической эффективности | 10 | 40
Офформление документации | 20 | 80
Всего: |  | 320

Sheet: Страховые выплаты
Вид выплат | Ставка | Сумма
Пенсионное страхование | 22.00% | 14960
ОМС | 5.10% | 3468
Социальное страхование | 2.90% | 1972
Страхование от несчастных случаев | 0.20% | 136
Всего: |  | 20536

Sheet: Окупаемость
Срок (месяц) | Ежемесячное производство |  | Предварительное производство
 | Тираж при +25% | Тираж при +50% | Тираж при +25% | Тираж при +50% | Стоимость | ППМ | Монтаж | Стоимость | ППМ | Монтаж
1 | 86.60318789 | 52.15017065 | 86.60318789 | 52.15017065 | 2728.16 ₽ | 308.04 ₽ | 300.00 ₽ | 2745.50 ₽ | 325.38 ₽ | 300.00 ₽
2 | 43.9663568 | 27.7157655 | 43.30159395 | 26.07508532 | 2745.50 ₽ | 325.38 ₽ | 300.00 ₽ | 2858.24 ₽ | 438.12 ₽ | 300.00 ₽
3 | 32.56094522 | 18.477177 | 28.8677293 | 17.38339022 | 2858.24 ₽ | 438.12 ₽ | 300.00 ₽ | 2858.24 ₽ | 438.12 ₽ | 300.00 ₽
4 | 24.42070892 | 16.56101765 | 21.65079697 | 13.03754266 | 2858.24 ₽ | 438.12 ₽ | 300.00 ₽ | 3150.70 ₽ | 630.58 ₽ | 400.00 ₽
5 | 19.53656713 | 13.24881412 | 17.32063758 | 10.43003413 | 2858.24 ₽ | 438.12 ₽ | 300.00 ₽ | 3150.70 ₽ | 630.58 ₽ | 400.00 ₽
6 | 22.85412387 | 11.04067843 | 14.43386465 | 8.691695108 | 3150.70 ₽ | 630.58 ₽ | 400.00 ₽ | 3150.70 ₽ | 630.58 ₽ | 400.00 ₽
7 | 19.58924903 | 9.463438655 | 12.37188398 | 7.450024378 | 3150.70 ₽ | 630.58 ₽ | 400.00 ₽ | 3150.70 ₽ | 630.58 ₽ | 400.00 ₽
8 | 17.1405929 | 8.280508823 | 10.82539849 | 6.518771331 | 3150.70 ₽ | 630.58 ₽ | 400.00 ₽ | 3150.70 ₽ | 630.58 ₽ | 400.00 ₽
9 | 15.23608258 | 8.904668406 | 9.622576432 | 5.794463405 | 3150.70 ₽ | 630.58 ₽ | 400.00 ₽ | 3410.70 ₽ | 890.58 ₽ | 400.00 ₽
10 | 13.71247432 | 8.014201565 | 8.660318789 | 5.215017065 | 3150.70 ₽ | 630.58 ₽ | 400.00 ₽ | 3410.70 ₽ | 890.58 ₽ | 400.00 ₽
11 | 12.46588575 | 9.612574161 | 7.873017081 | 4.740924604 | 3150.70 ₽ | 630.58 ₽ | 400.00 ₽ | 3710.70 ₽ | 890.58 ₽ | 700.00 ₽
12 | 11.42706193 | 8.811526314 | 7.216932324 | 4.345847554 | 3150.70 ₽ | 630.58 ₽ | 400.00 ₽ | 3710.70 ₽ | 890.58 ₽ | 700.00 ₽
Кол-во |  | Производство ППМ | Монтаж элементов
1 | 2970.58 ₽ | 2970.58 ₽ | 1000.00 ₽ |  | 2728.16 ₽ | 2745.50 ₽
5 | 4452.90 ₽ | 890.58 ₽ | 700.00 ₽
10 | 6305.76 ₽ | 630.58 ₽ | 400.00 ₽
25 | 10953.00 ₽ | 438.12 ₽ | 300.00 ₽
50 | 16269.00 ₽ | 325.38 ₽ | 300.00 ₽
75 | 23103.00 ₽ | 308.04 ₽ | 300.00 ₽
100 | 28114.80 ₽ | 281.15 ₽ | 250.00 ₽
150 | 40872.60 ₽ | 272.48 ₽ | 250.00 ₽
