maxim5858mru/graduate-work-college-tiu/Altium Designer Project/Project Outputs for Graduate Work/PCB Job.pdf

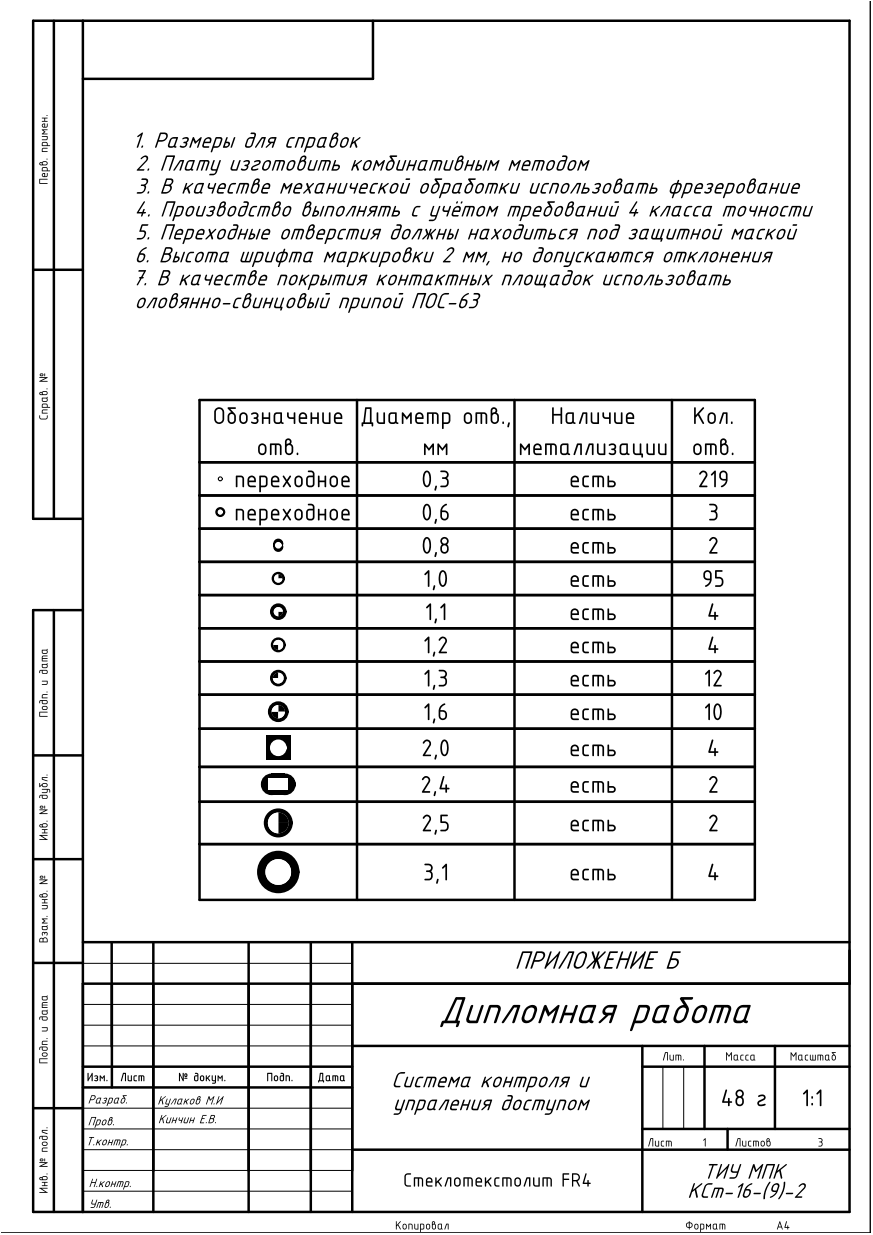
[picture p43: page 1]
CODesignator1

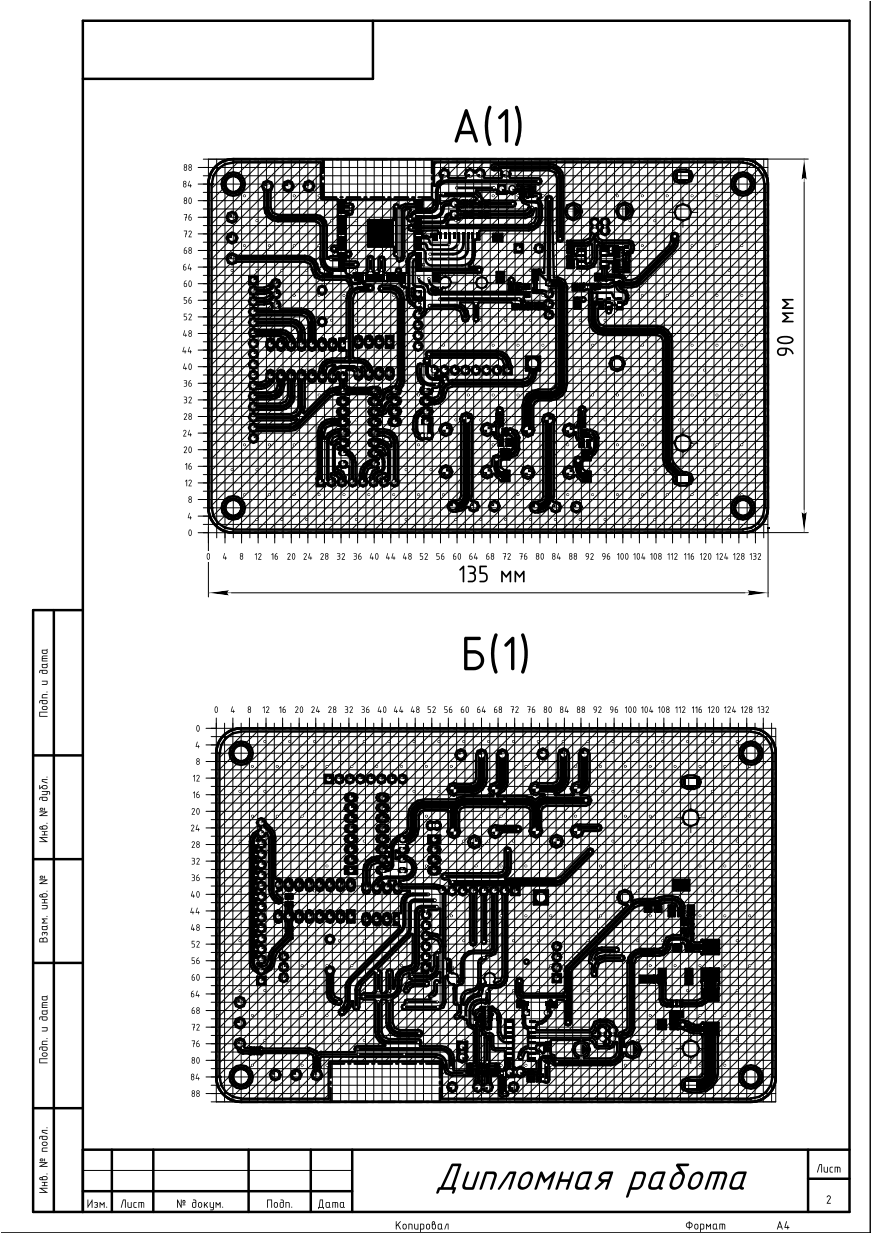
[picture p44: page 2]
CODesignator1

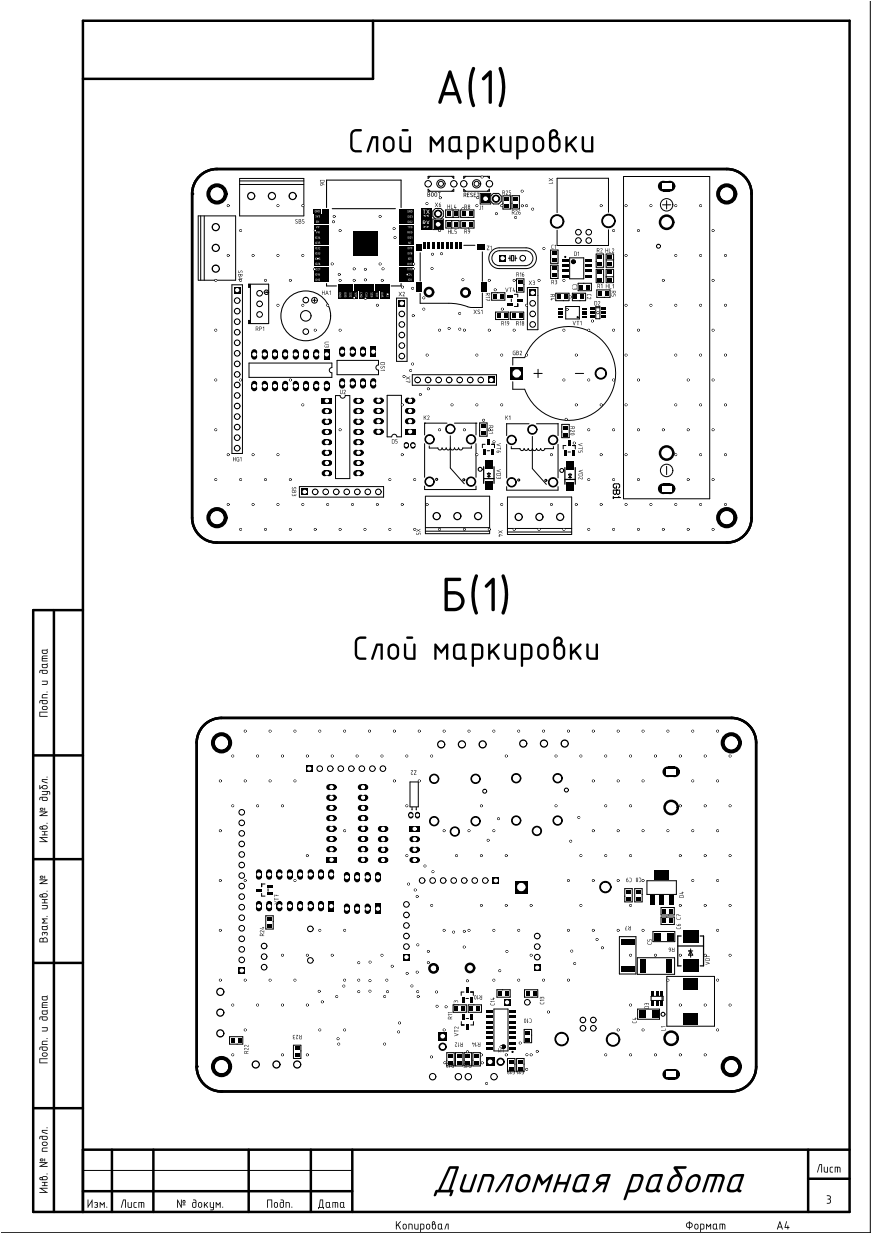
[picture p45: page 3]
CODesignator1
