maxim5858mru/graduate-work-college-tiu/Text/Дипломная работа/Приложение А.pdf

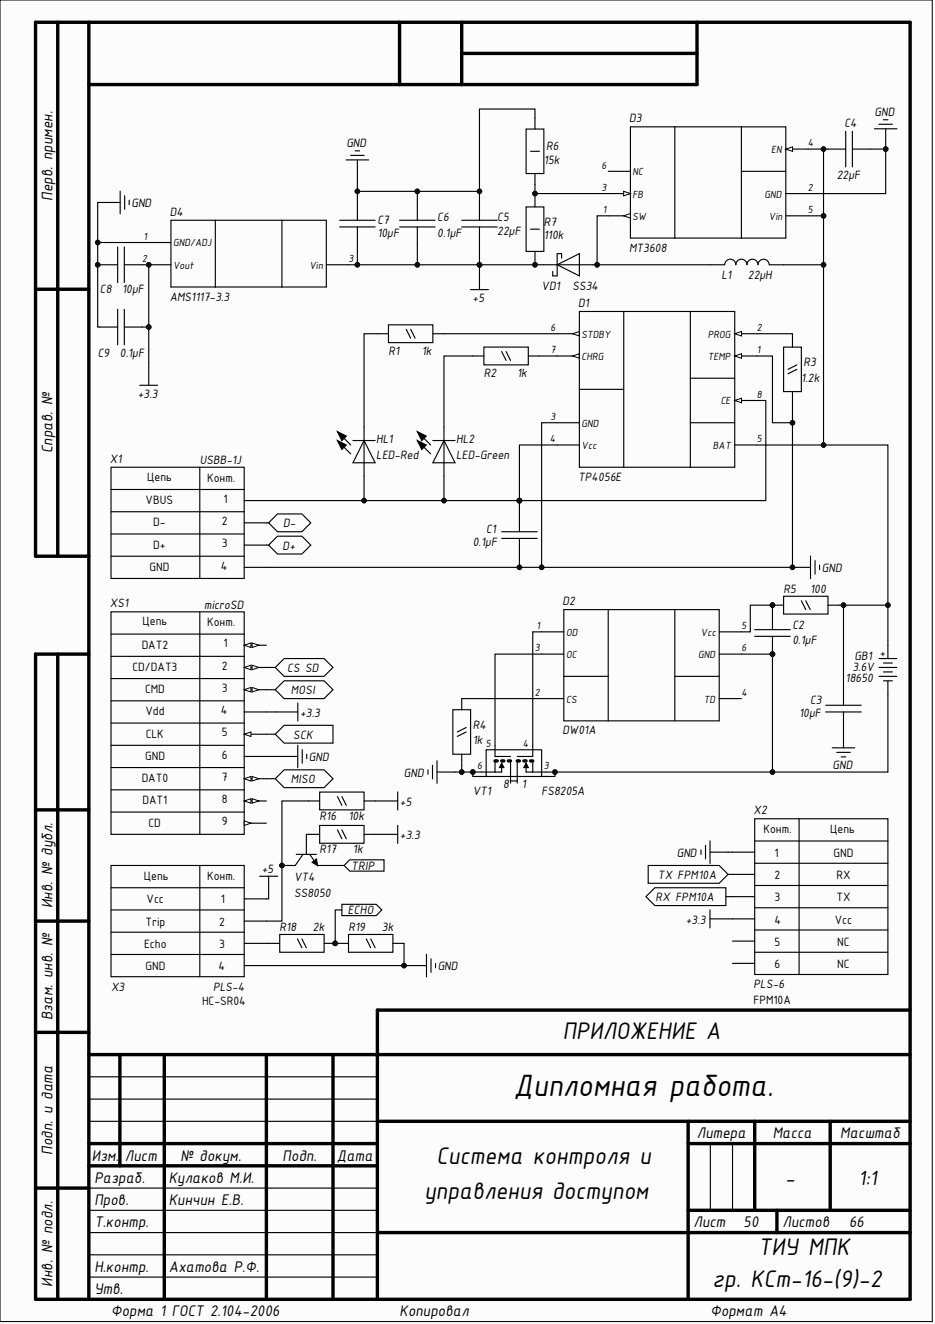
[picture p52: page 1]

CHRG 7

GND 3

VBUS | 1

GND | 4

GND

CD/DAT3 | 2

CMD | 3

Vdd | 4

CLK | 5

GND | 6

DAT0 | 7

DAT1 | 8
CD | 9 | R16 10k

Конт. | Цепь

1 | GND

Дипломная работа.

Инв. № подл. Подп. и да

Система контроля и управления доступом | Литера | Масса | Масштаб

Изм. Лист | № докум. | Подп. | Дата | | | | | - | 1:1
Разраб. | Кулаков М.И.
Пров. | Кинчин Е.В.
Т.контр. | | | | Лист 50 | Листов 66

ТИУ МПК гр. КСт-16-(9)-2

Н.контр. | Ахатова Р.Ф.
Утв.

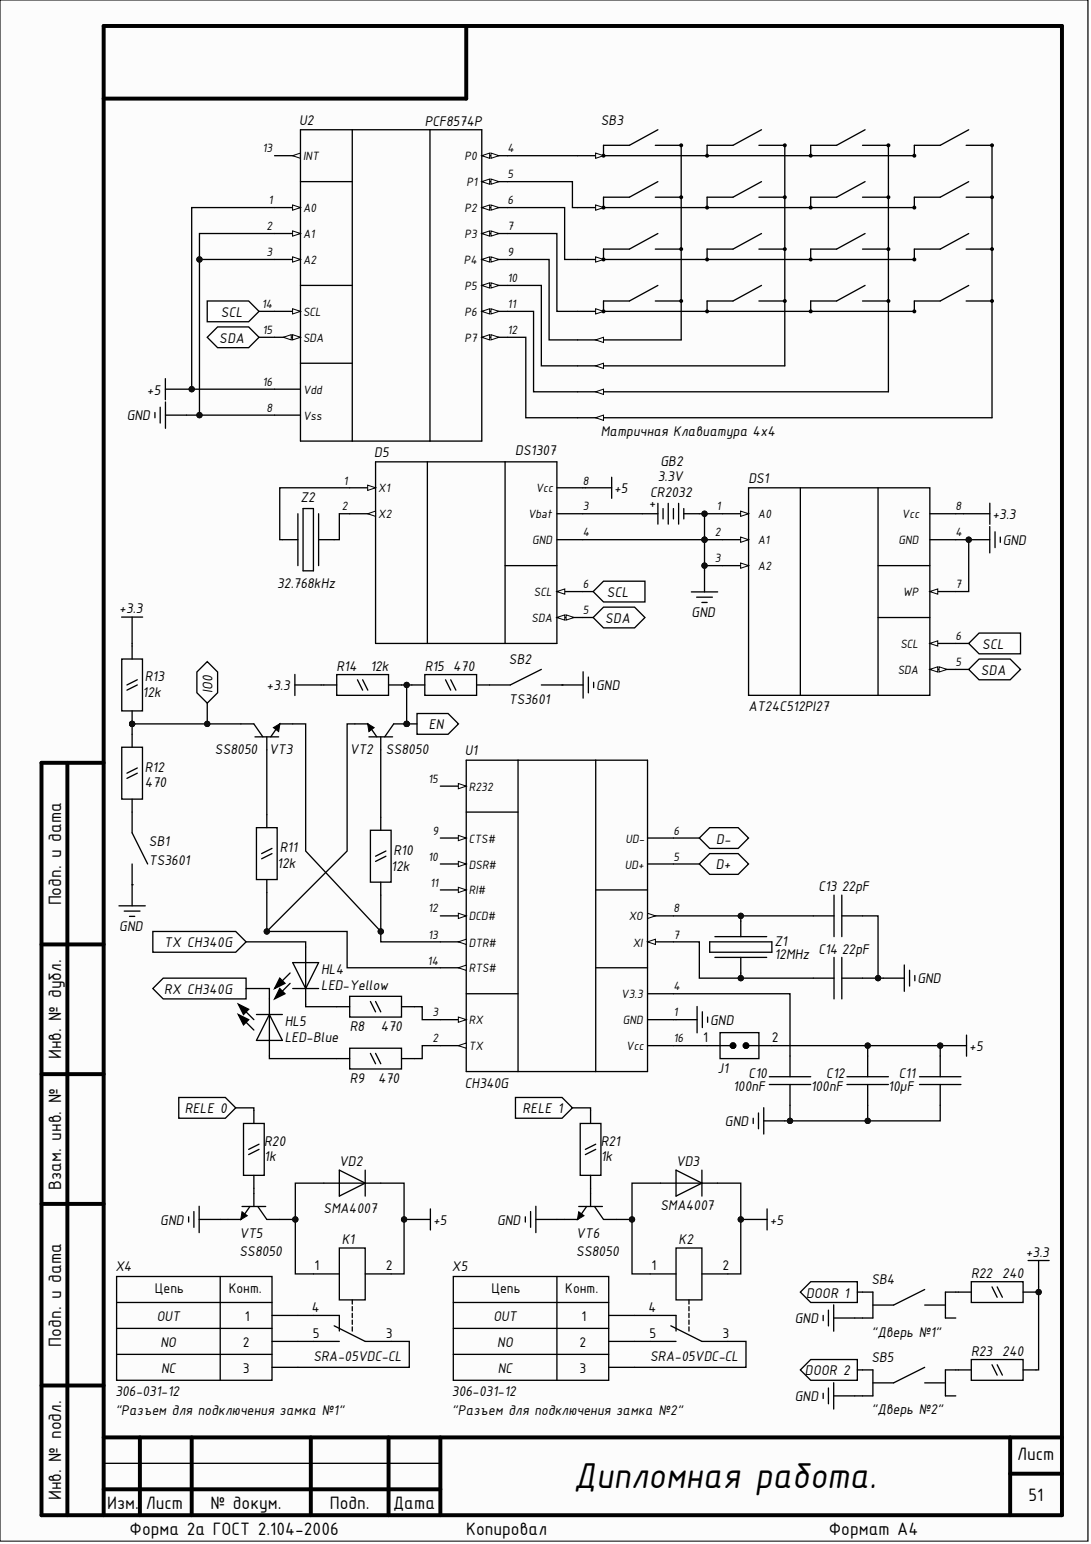
[picture p53: page 2]

Инв. № подл. Подп. и дата Взам. инв. № Инв. № дубл. Подп. и дата

DSR# 10 | | 5

DCD# 12 | XI

12MHz

"Разъем для подключения замка №1"

"Разъем для подключения замка №2"

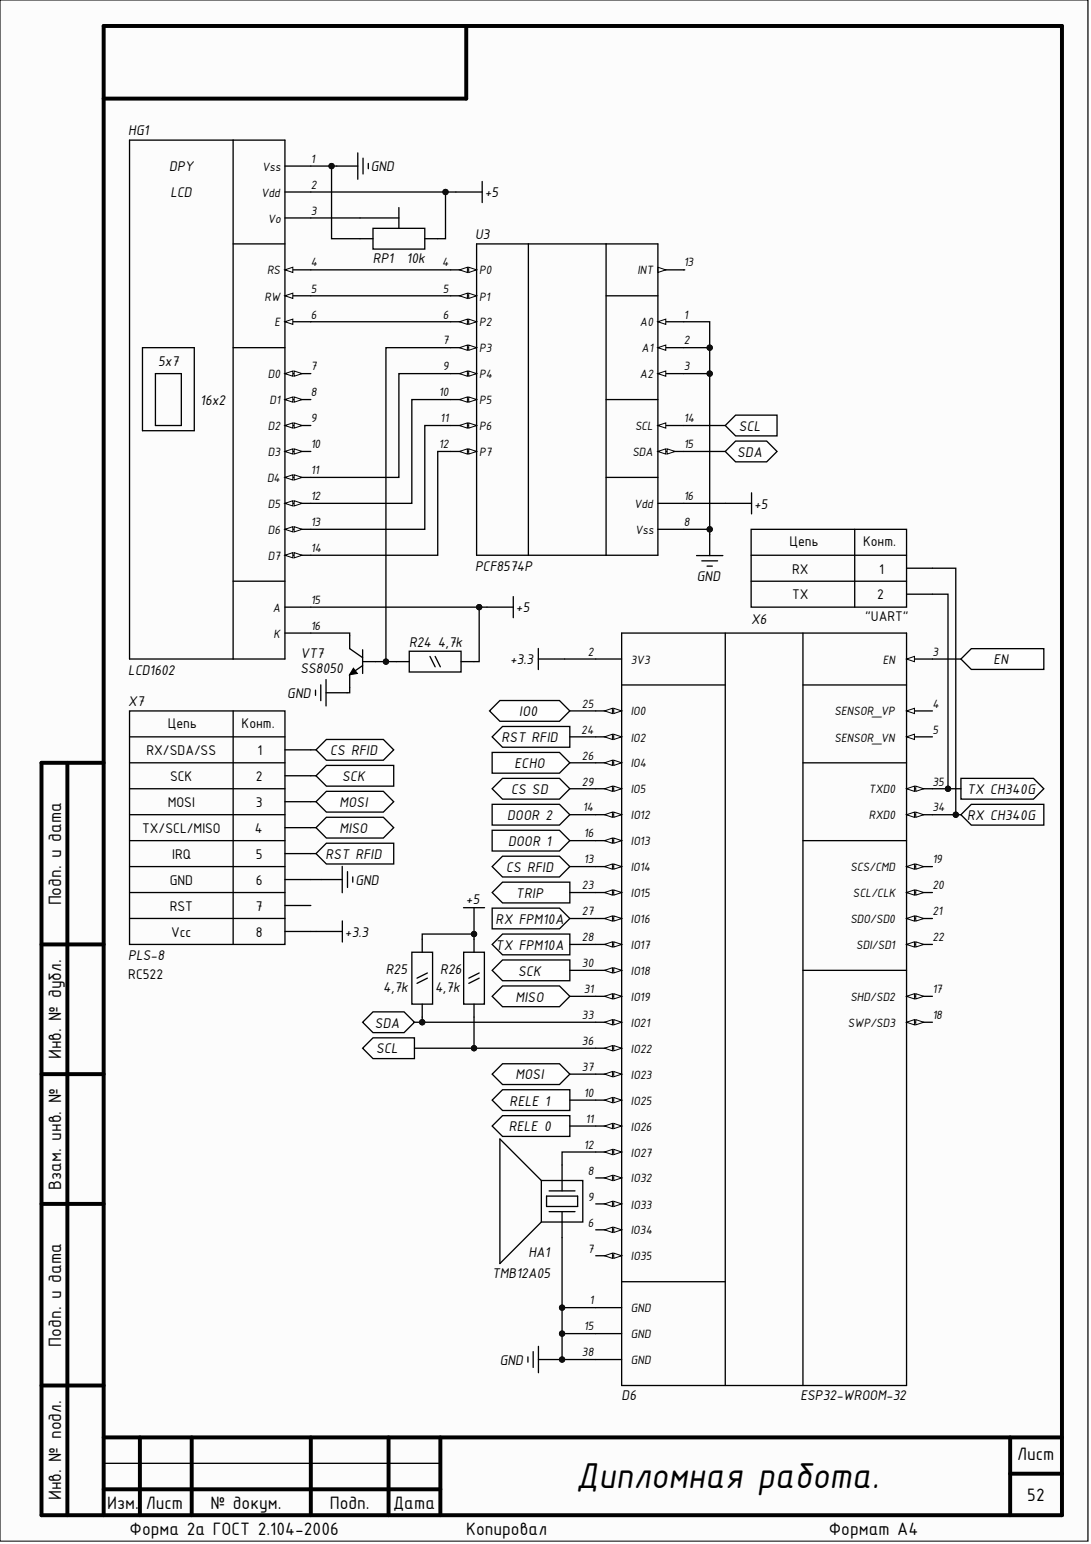
[picture p54: page 3]

Цепь | Конт.

RX/SDA/SS | 1

SCK | 2

MOSI | 3

Инв. № подл. Подп. и дата Взам. инв. № Инв. № дубл. Подп. и дата

TX/SCL/MISO | 4

IRQ | 5

GND | 6

RST | 7

Vcc | 8

52 Изм.

Лист | № докум. | Подп. | Дата

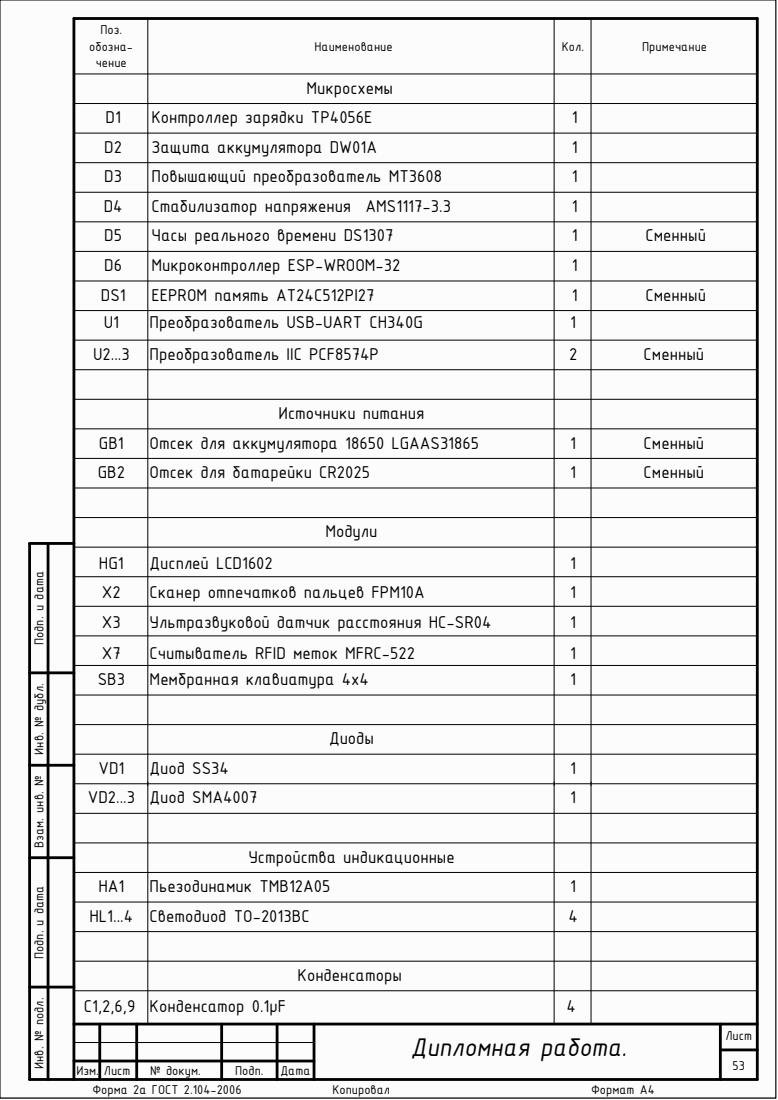
[picture p55: page 4]

Поз. обозна-чение | Наименование | Кол. | Примечание

Микросхемы

D1 | Контроллер зарядки TP4056E | 1
D2 | Защита аккумулятора DW01A | 1
D3 | Повышающий преобразователь MT3608 | 1
D4 | Стабилизатор напряжения AMS1117-3.3 | 1
D5 | Часы реального времени DS1307 | 1 | Сменный
D6 | Микроконтроллер ESP-WROOM-32 | 1
DS1 | EEPROM память AT24C512PI27 | 1 | Сменный
U1 | Преобразователь USB-UART CH340G | 1

U2...3 | Преобразователь IIC PCF8574P | 2 | Сменный

Источники питания

GB1 | Отсек для аккумулятора 18650 LGAAS31865 | 1 | Сменный
GB2 | Отсек для батарейки CR2025 | 1 | Сменный

Модули

HG1 | Дисплей LCD1602 | 1
X2 | Сканер отпечатков пальцев FPM10A | 1
X3 | Ультразвуковой датчик расстояния HC-SR04 | 1

Инв. № подл. Подп. и дата Взам. инв. № Инв. № дубл. Подп. и дата

X7 | Считыватель RFID меток MFRC-522 | 1
SB3 | Мембранная клавиатура 4x4 | 1

Диоды

VD1 | Диод SS34 | 1
VD2...3 | Диод SMA4007 | 1

Устройства индикационные

HA1 | Пьезодинамик TMB12A05 | 1
HL1...4 | Светодиод TO-2013BC | 4

Конденсаторы

С1,2,6,9 | Конденсатор 0.1µF | 4

Лист | № докум. | Подп. | Дата

53 Изм.

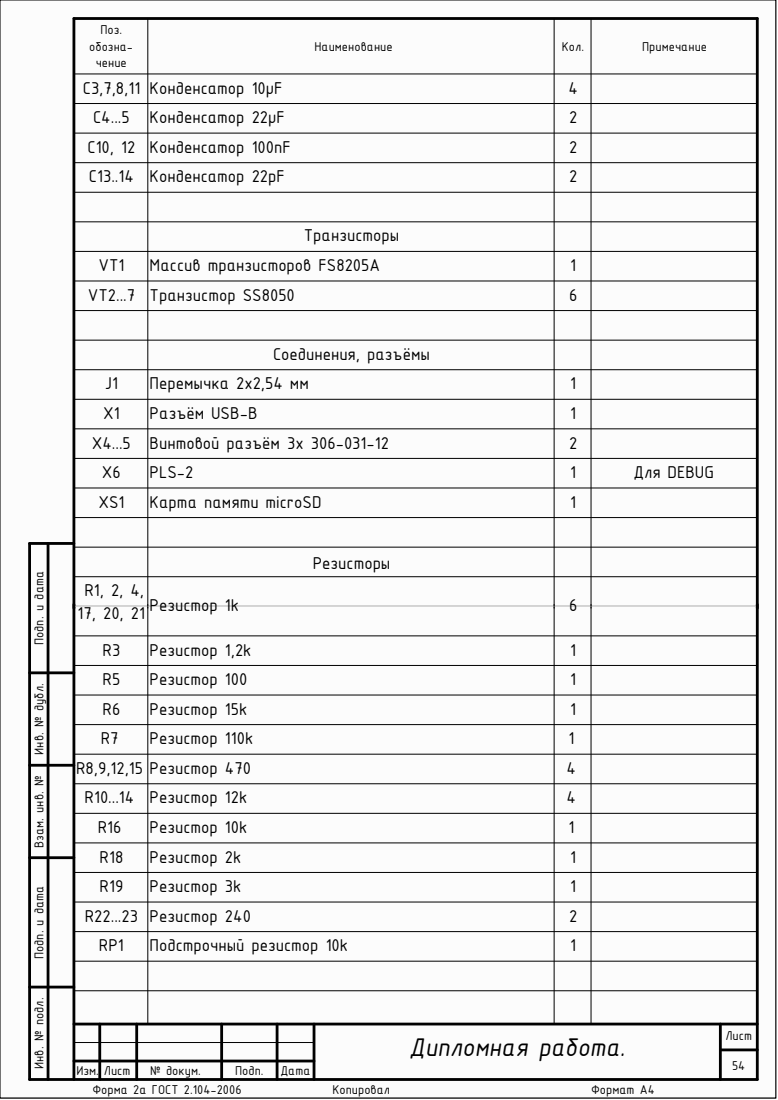
[picture p56: page 5]

С3,7,8,11 | Конденсатор 10µF | 4
С4...5 | Конденсатор 22µF | 2
С10, 12 | Конденсатор 100nF | 2
С13..14 | Конденсатор 22pF | 2

Транзисторы

VT1 | Массив транзисторов FS8205A | 1
VT2...7 | Транзистор SS8050 | 6

Соединения, разъёмы

J1 | Перемычка 2x2,54 мм | 1
X1 | Разъём USB-B | 1
X4...5 | Винтовой разъём 3x 306-031-12 | 2
X6 | PLS-2 | 1 | Для DEBUG
XS1 | Карта памяти microSD | 1

Резисторы

Инв. № подл. Подп. и дата Взам. инв. № Инв. № дубл. Подп. и дата

R1, 2, 4,
17, 20, 21 Резистор 1k | | 6

R3 | Резистор 1,2k | 1
R5 | Резистор 100 | 1
R6 | Резистор 15k | 1
R7 | Резистор 110k | 1
R8,9,12,15 | Резистор 470 | 4
R10...14 | Резистор 12k | 4
R16 | Резистор 10k | 1
R18 | Резистор 2k | 1
R19 | Резистор 3k | 1
R22...23 | Резистор 240 | 2
RP1 | Подстрочный резистор 10k | 1

54 Изм.

Лист | № докум. | Подп. | Дата

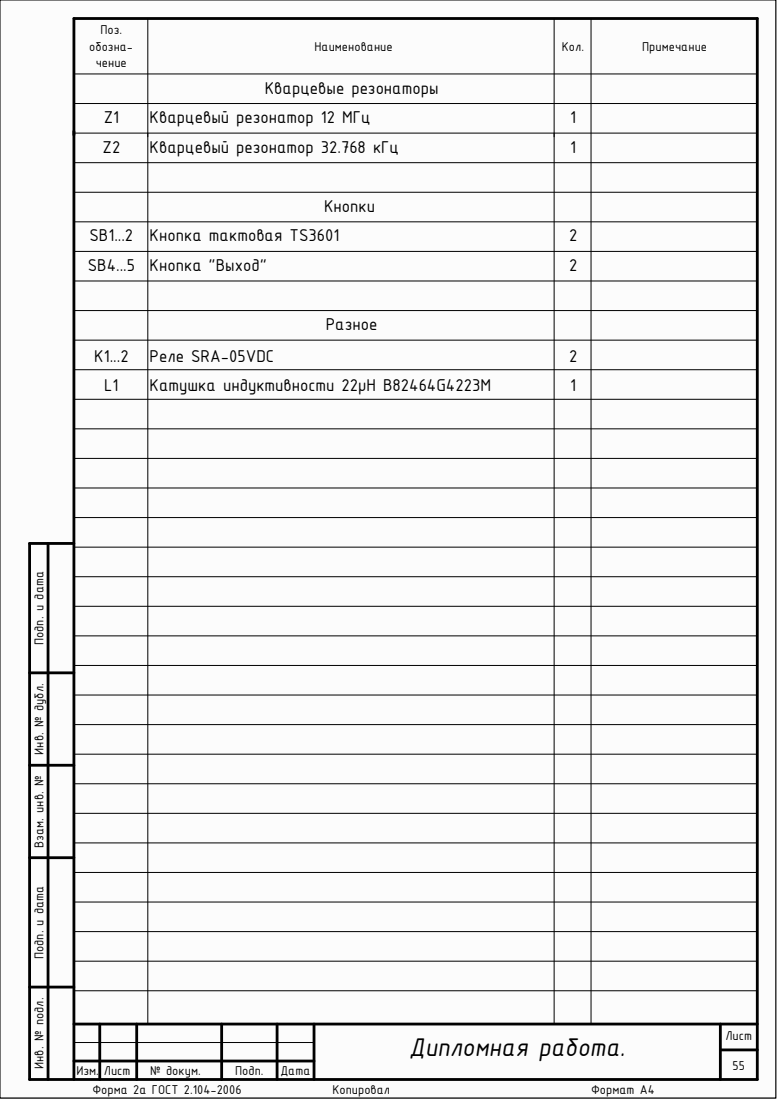
[picture p57: page 6]

Кварцевые резонаторы

Z1 | Кварцевый резонатор 12 МГц | 1
Z2 | Кварцевый резонатор 32.768 кГц | 1

Кнопки

SB1...2 | Кнопка тактовая TS3601 | 2
SB4...5 | Кнопка "Выход" | 2

Разное

K1...2 | Реле SRA-05VDC | 2
L1 | Катушка индуктивности 22µH B82464G4223M | 1

Инв. № подл. Подп. и дата Взам. инв. № Инв. № дубл. Подп. и дата

55 Изм.

Лист | № докум. | Подп. | Дата
