maxim5858mru/graduate-work-college-tiu/Text/Дипломная работа/Приложение Б.pdf

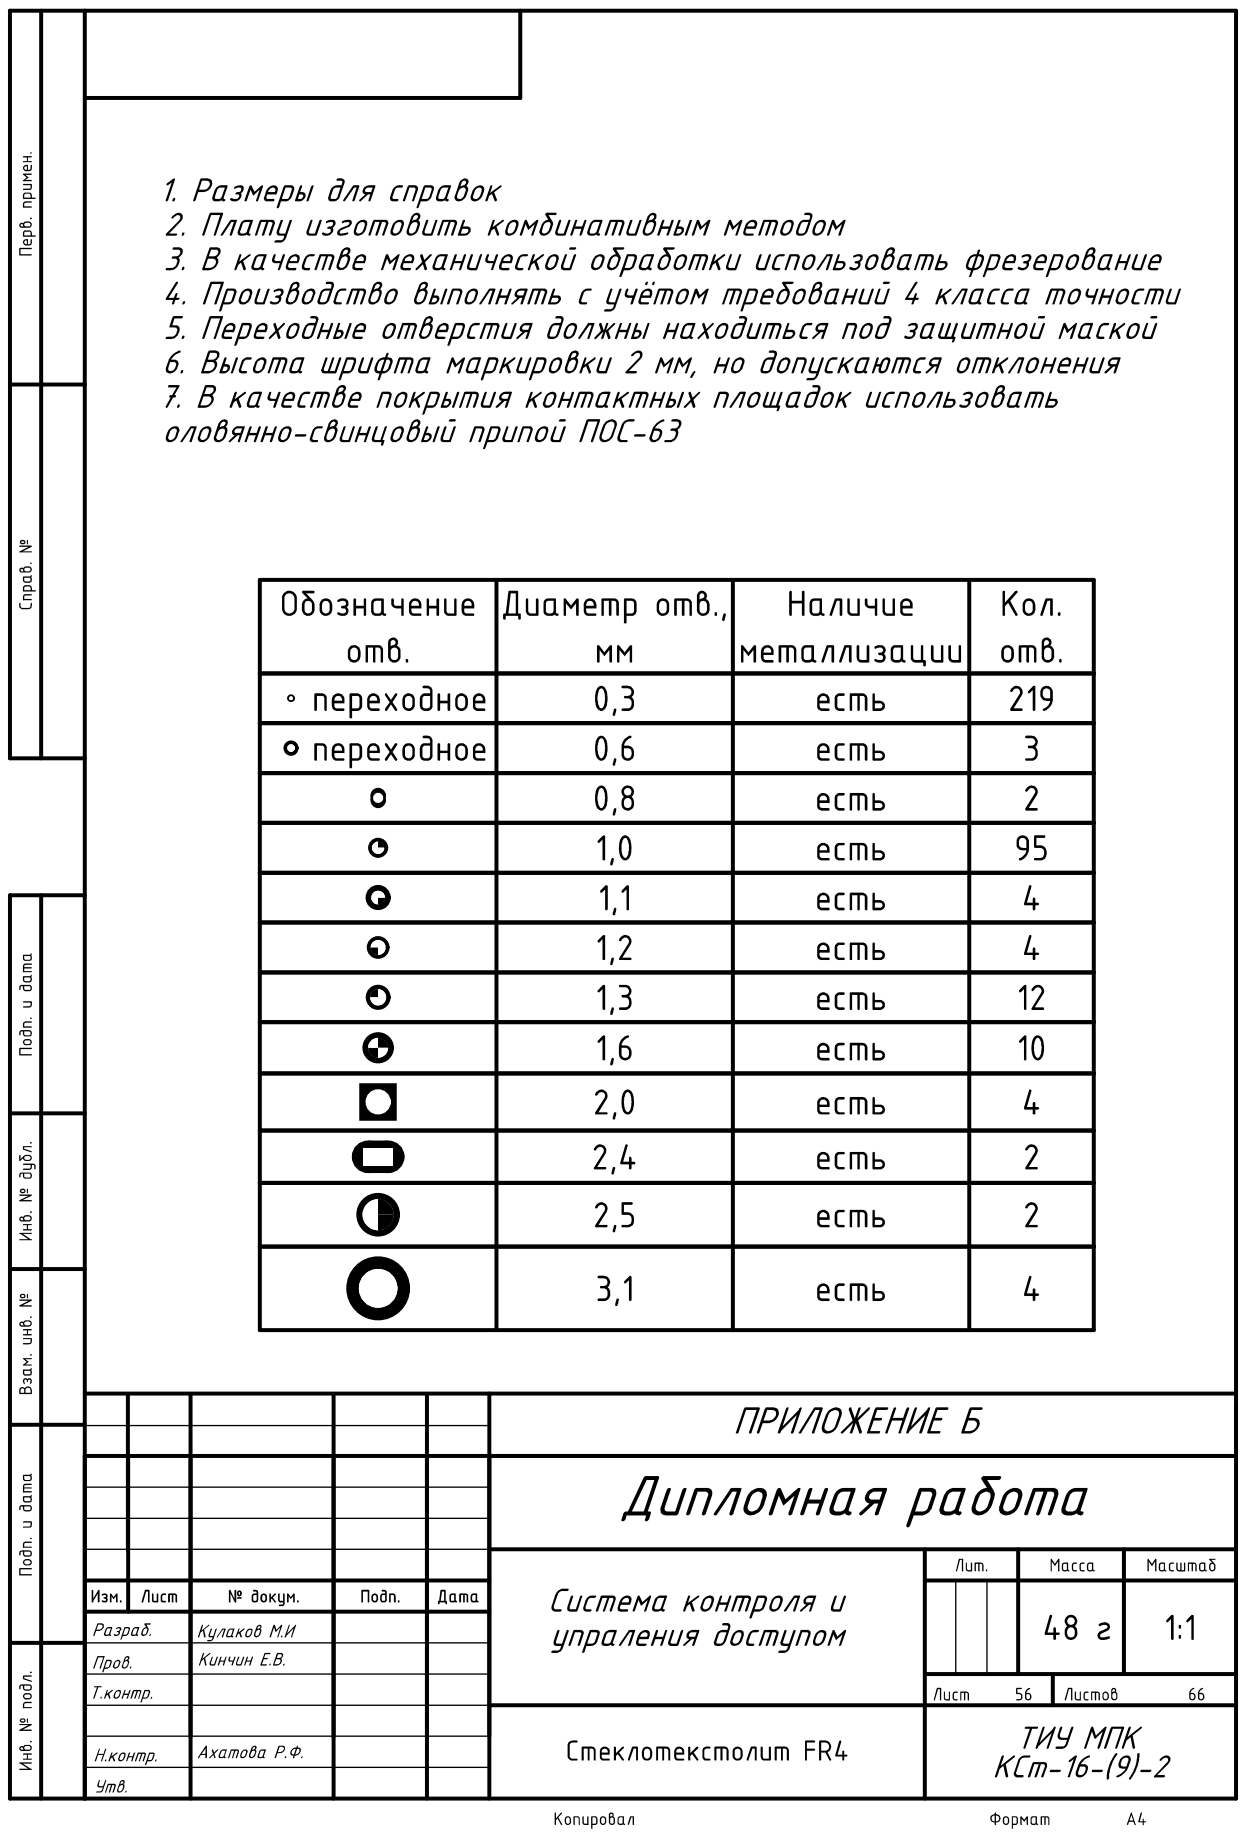
[picture p58: page 1]

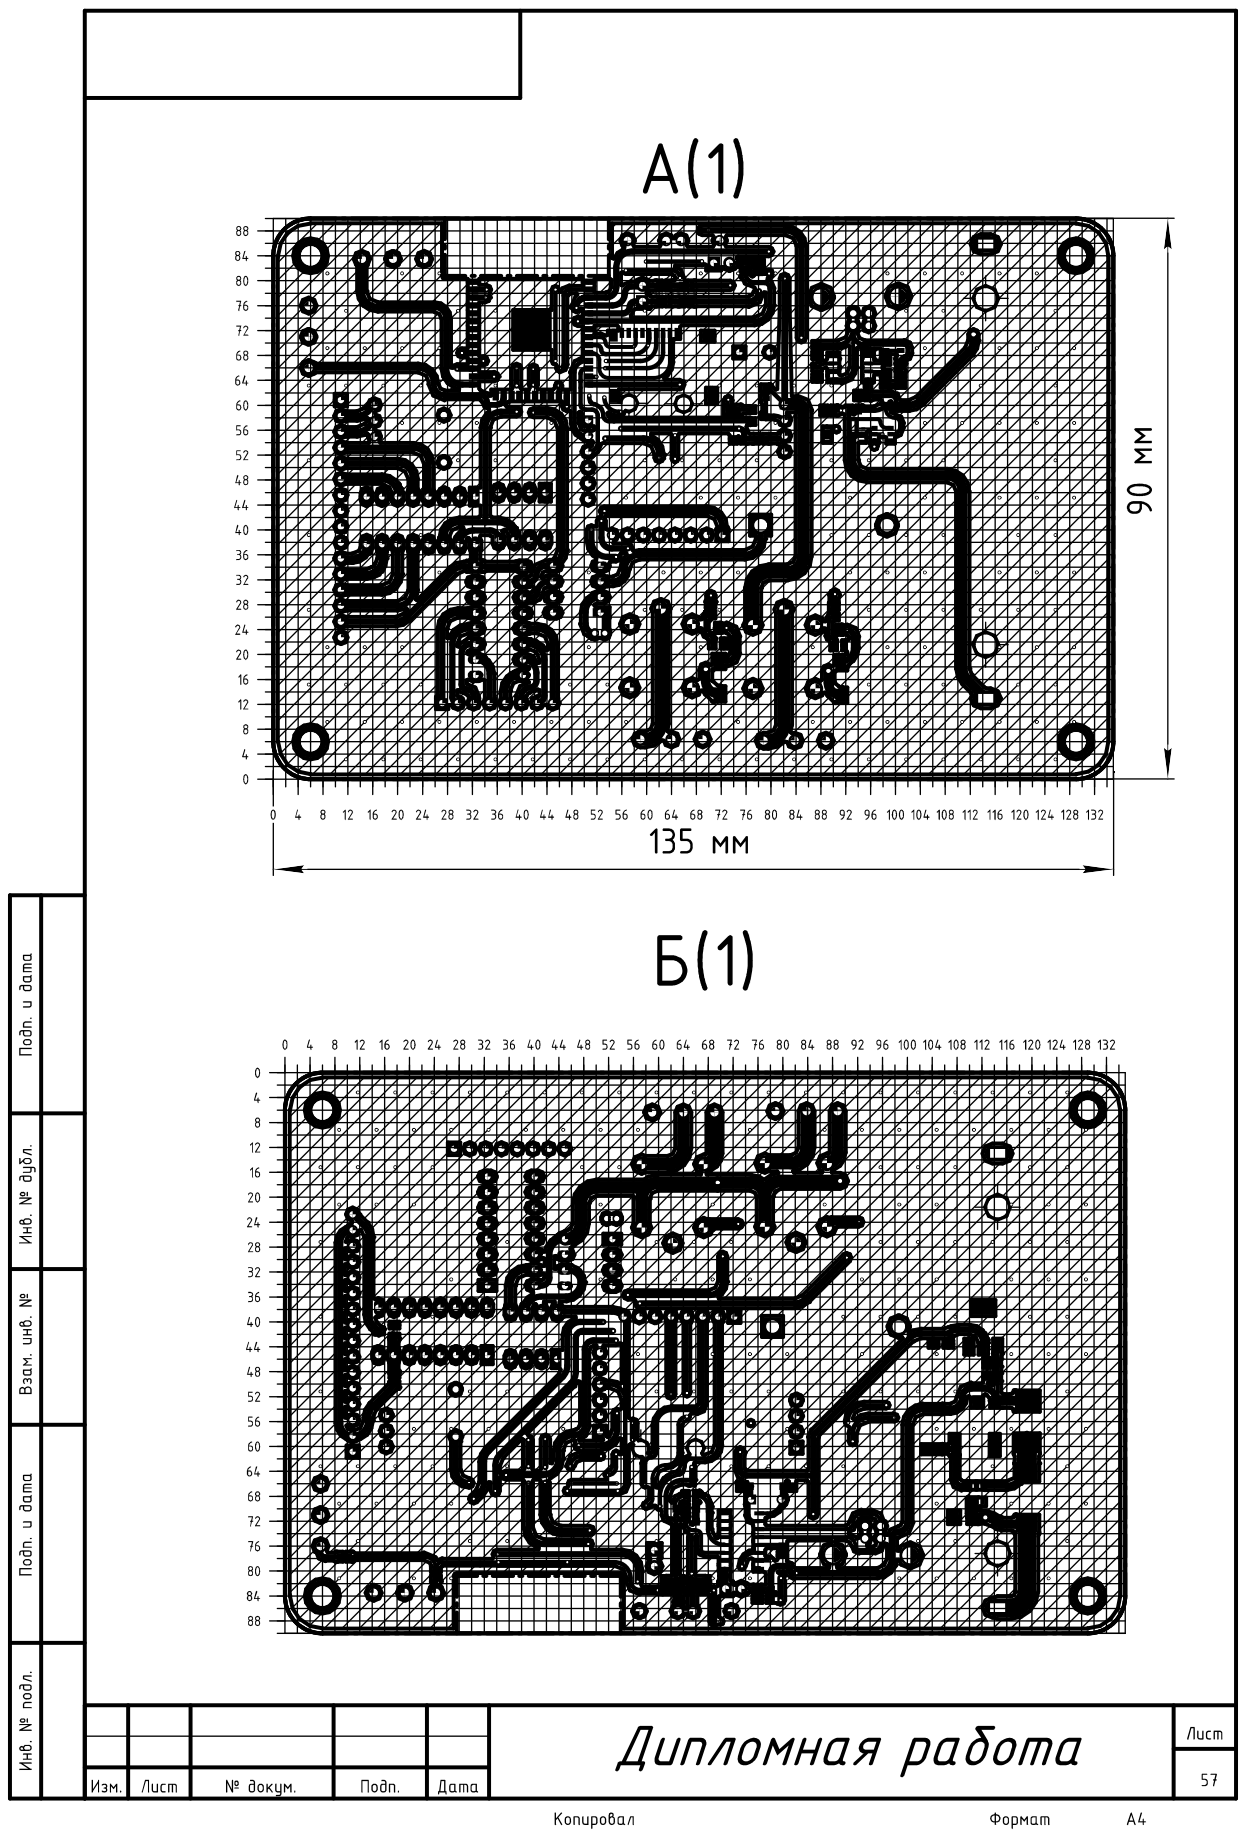
[picture p59: page 2]

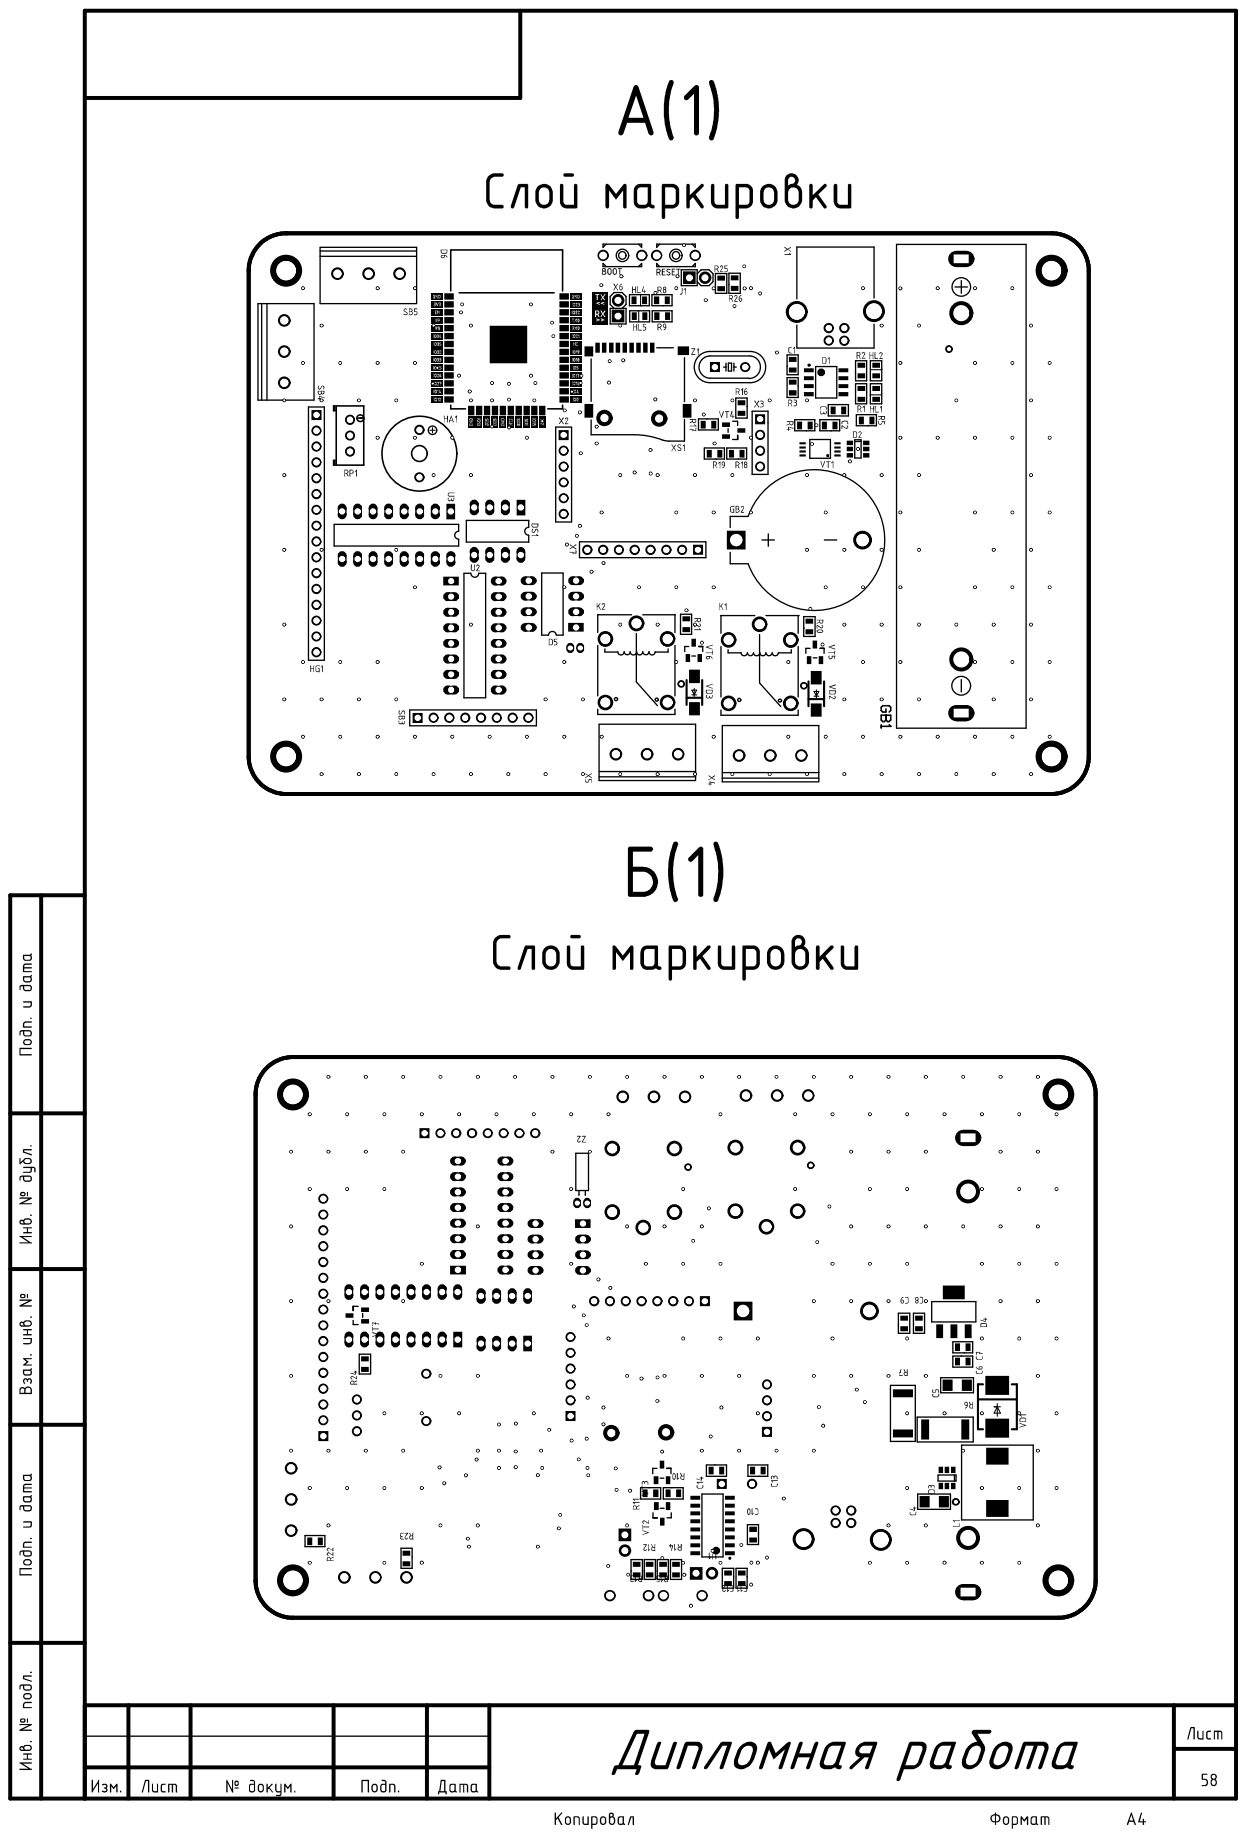
[picture p60: page 3]
