maxim5858mru/graduate-work-college-tiu/Text/Практика/Приложение А и Б (чертёж).pdf

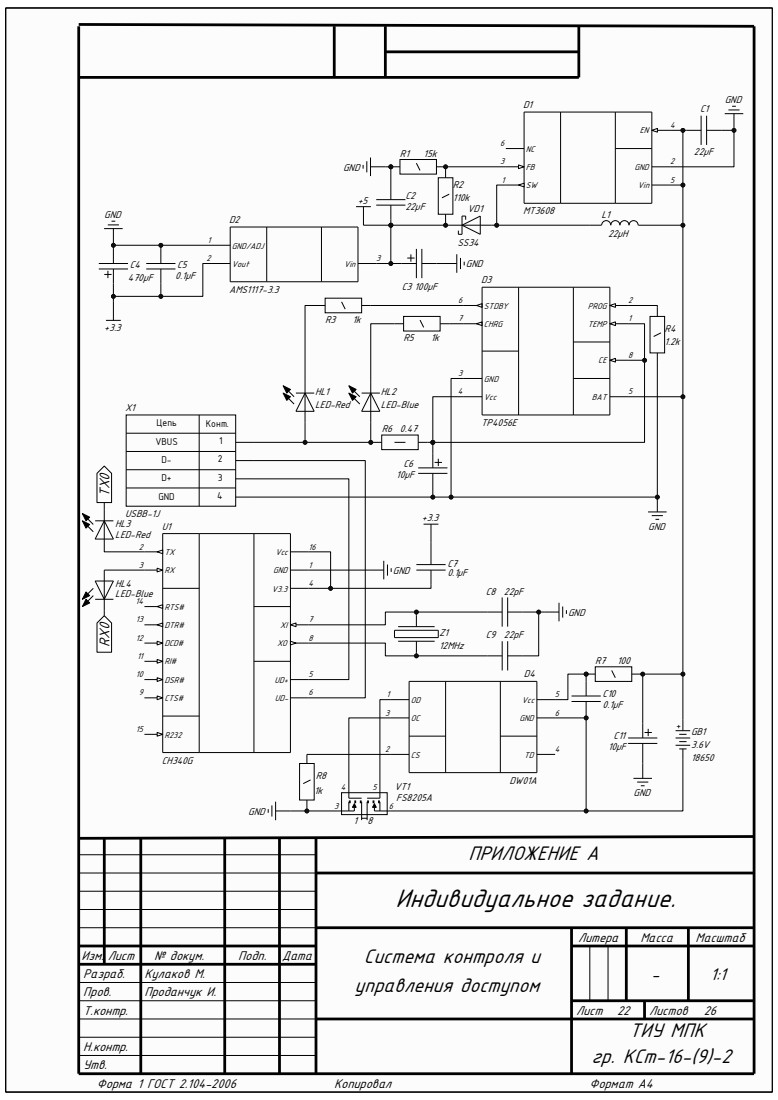
[picture p61: page 1]

OD OC | Vcc GND

ПРИЛОЖЕНИЕ А
Индивидуальное задание.

Система контроля и управления доступом | Литера | Масса | Масштаб

Изм. Лист | № докум. | Подп. | Дата | | | | | - | 1:1
Разраб. | Кулаков М.
Пров. | Проданчук И.
Т.контр. | | | | Лист | Листов 22 26

ТИУ МПК гр. КСт-16-(9)-2

Н.контр.
Утв.

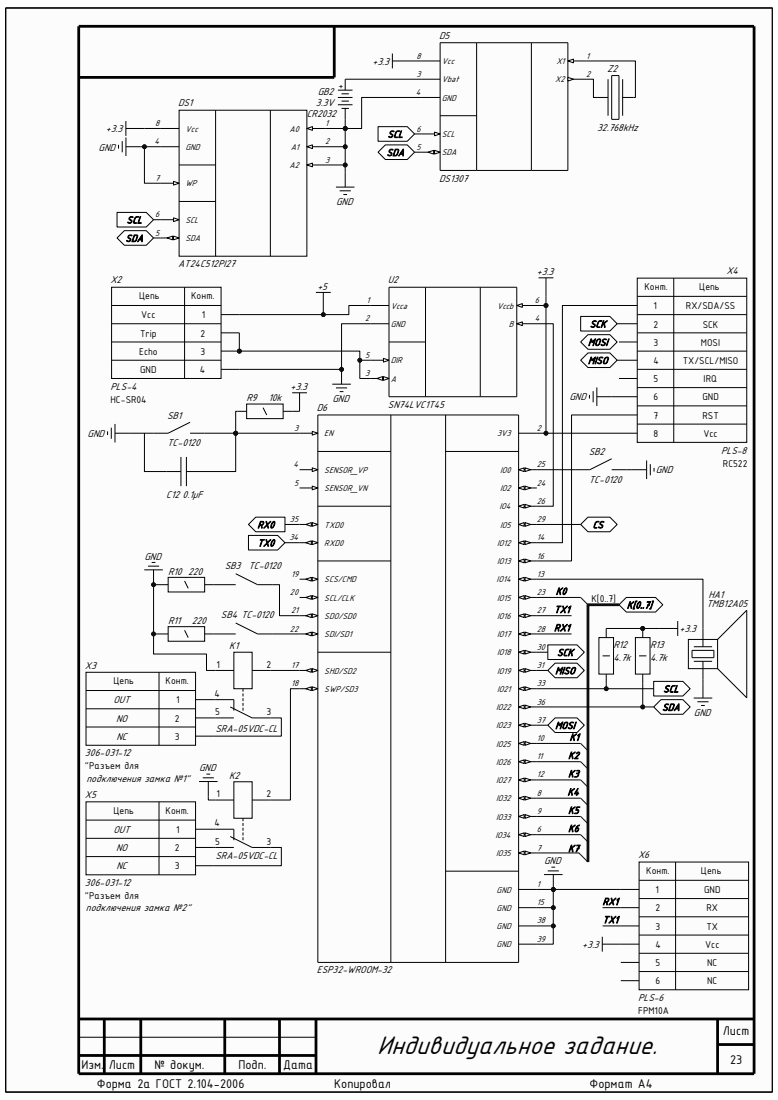
[picture p62: page 2]

Vcc Vbat GND | | X1 X2

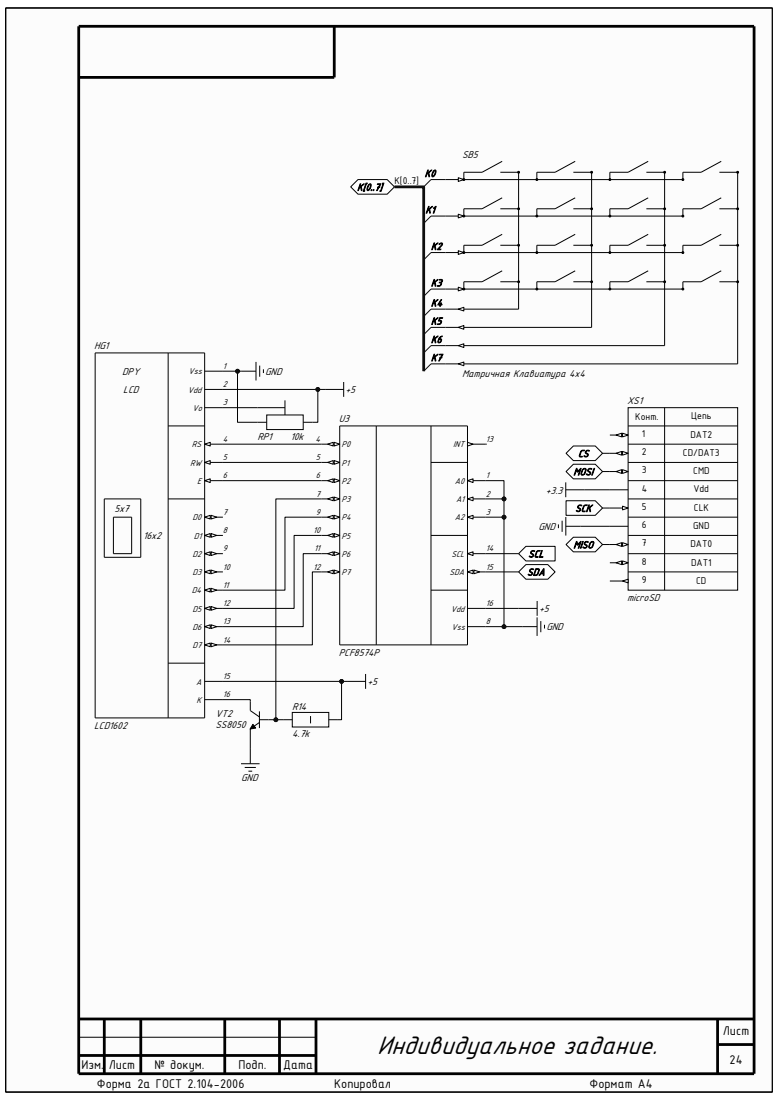
[picture p63: page 3]

24 Изм.

Лист | № докум. | Подп. | Дата

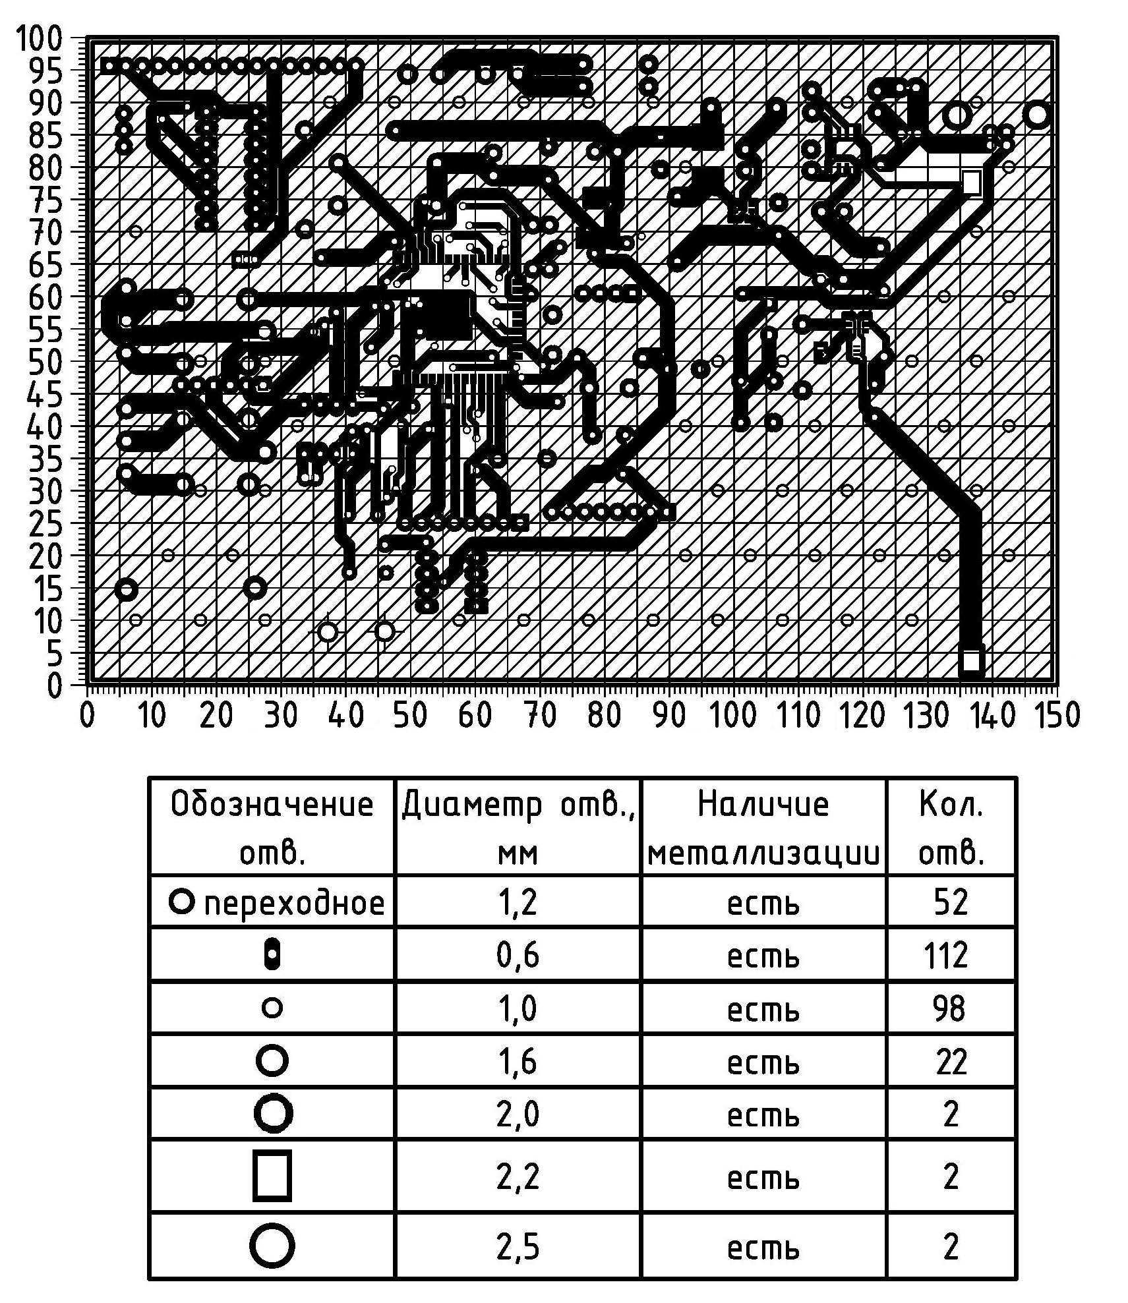
[picture p64: figure]

Форма 1 ГОСТ 2.104-2006 | Копировал | Формат А4

Н.контр.
Утв.
| | | | ПРИЛОЖЕНИЕ Б
| | | | Индивидуальное задание.
| | | | Система контроля и управления доступом | Литера | Масса | Масштаб
Изм. Лист | № докум. | Подп. | Дата | | | | | 14 г. | 1:1
Разраб. | Кулаков М.
Пров. | Проданчук И.
Т.контр. | | | | Лист | Листов 25 26
| | | | ТИУ МПК гр. КСт-16-(9)-2

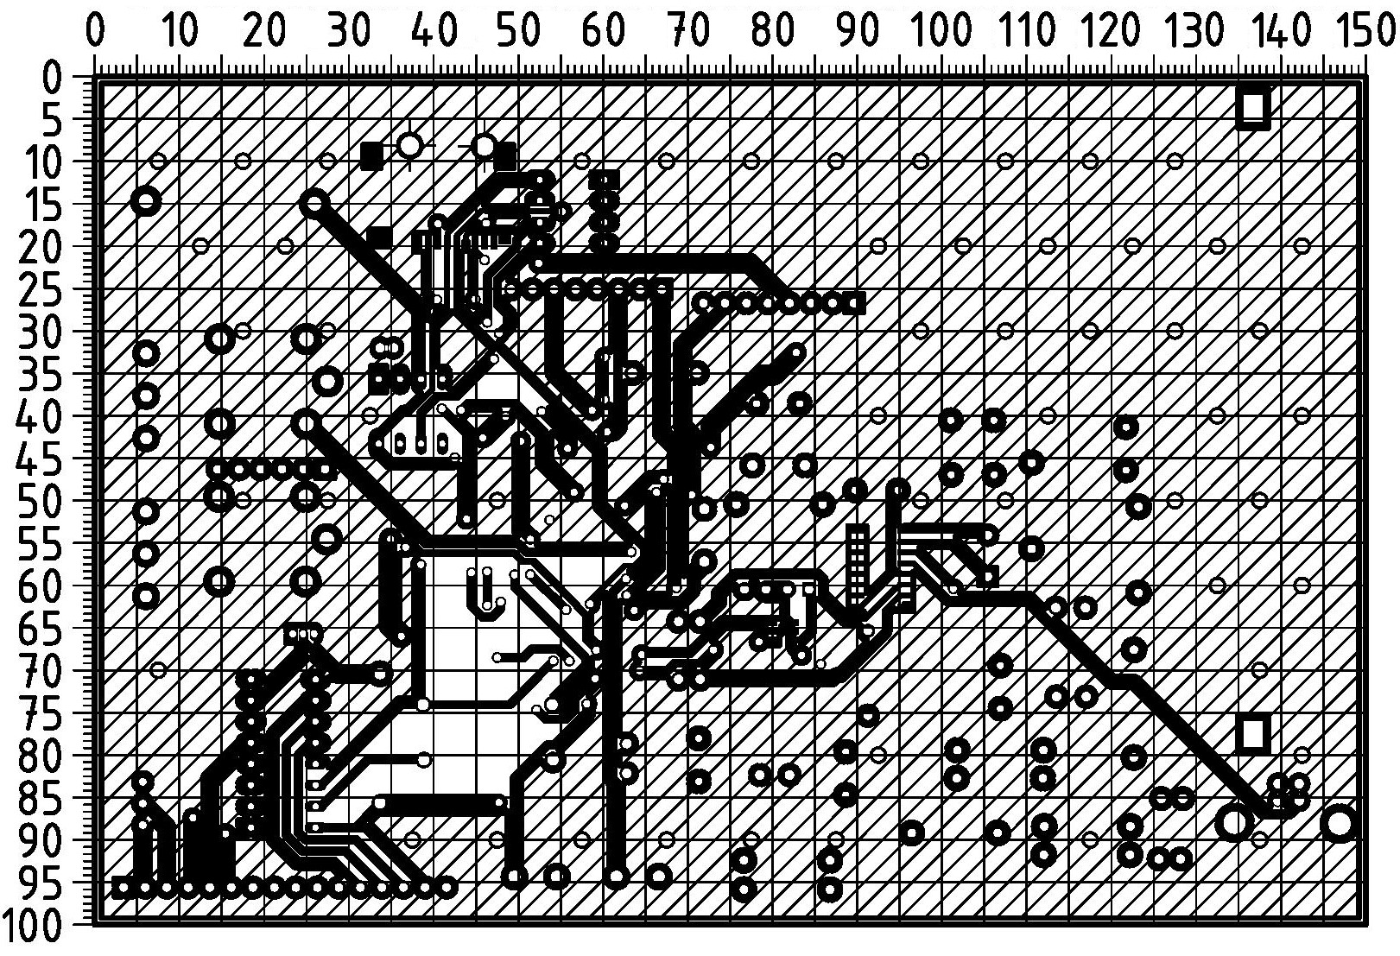
[picture p65: figure]

| | | | 26 Изм.
Лист | № докум. | Подп. | Дата
