maxim5858mru/graduate-work-college-tiu/(list of files, drawings)

Other design files:
Altium Designer Project/Graduate Work.PrjPcb
Altium Designer Project/PCB.PcbDoc
Altium Designer Project/Sheet1.SchDoc
Altium Designer Project/Sheet2.SchDoc
Altium Designer Project/Sheet3.SchDoc
Altium Designer Project/Sheet4.SchDoc
Altium Designer Project/Sheet5.SchDoc
Altium Designer Project/Sheet6.SchDoc
