maxim5858mru/graduate-work-college-tiu/(commit log)

2020-02-19 Altium, test EEPROM, text and etc.
    [Graduate Work.PrjPcb, PCB.PcbDoc, Sheet.SchDoc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]
2020-02-23 Перенос кода между устройствами
2020-02-26 Промежуточное сохранение, переписана (но не проверена) EEPROM.
2020-03-15 Доделана курсовая, исправлена ошибка в схеме.
    [Graduate Work.PrjPcb, Sheet1.SchDoc, Sheet2.SchDoc, Sheet3.SchDoc]
2020-03-29 Дописан код библиотеки EEPROM
2020-04-06 Промежуточное сохранение
2020-04-13 Функции отвечающие за работу с сетью вынесены в отдельный файл. Дописана библиотека Timer, на основе стандартной бибилиотеки Ticker.
2020-04-15 Закончил перенос кода на Platformio IDE. Подключил Web сервер.
2020-05-02 Написана библиотека для I2C клавиатуры.
2020-05-05 Промежуточное сохранение. Закончены функции ввода PIN-кода и считывания RFID меток.
2020-05-06 Замена SPIFFS на SD
2020-05-10 Промежуточное сохранение.
    [Graduate Work.PrjPcb, Sheet.SchDoc, Sheet1.SchDoc, Sheet2.SchDoc, Sheet3.SchDoc]
2020-05-12 Дописана библиотека Clock
2020-05-20 Полностью переделана плата
    Исправлены все найденные ошибки (9).
    [BSheet1.SchDoc, BSheet2.SchDoc, BSheet3.SchDoc, Bill of Materials-Graduate Work.xlsx, Graduate Work.PrjPcb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]
2020-05-26 Добавлена текстовая часть диплома.
    [Bill of Materials-Graduate Work.xlsx, Graduate Work.PrjPcb, Sheet1.SchDoc, Sheet2.SchDoc, Sheet3.SchDoc, Размеры элементов.xlsx, Расчёт экономической эффективности.xlsx]
2020-05-31 Текстовая часть готова на 95%
    Нужно исправить приложения А, Б и В. Добавить в экономический расчёт стоимости электроэнергии.
    [Graduate Work.PrjPcb, Sheet1.SchDoc, Размеры элементов.xlsx, Расчёт экономической эффективности.xlsx]
2020-06-02 Дописана письменная часть
    Исправлен экономический расчёт. Убранны сокращения кроме СКУД. Начата презентация, создана основная структура.
    НЕОБХОДИМО наполнить презентацию схемами. И нужен видеоролик для демонстрации.
    [BSheet1.SchDoc, BSheet2.SchDoc, BSheet3.SchDoc, Bill of Materials-Graduate Work.xlsx, Graduate Work.PrjPcb, Sheet1.SchDoc, Sheet2.SchDoc, Sheet3.SchDoc]
2020-06-05 Изменена структура проекта
2020-06-06 Полностью дописана письменная часть
    Наконец. Жесть...
    [Graduate Work.PrjPcb, Sheet1.SchDoc, Sheet2.SchDoc, Sheet3.SchDoc, Sheet4.SchDoc, Sheet5.SchDoc, Sheet6.SchDoc, Расчёт экономической эффективности.xlsx]
2020-06-06 Исправлена ошибка с заголовком таблицы №13
2020-06-08 Добавлены файлы сервера
    [pyvenv.cfg]
2020-06-09 Сделана синхронизация при авторизации через PIN
2020-06-09 Полностью доделана синхронизация (не считая SD)
2020-06-12 Доделан комплект документов.
    Исправлена ВКР, рецензия и титульный лист. Добавленн отзыв и подтверждение (об ознакомлении с сроками защиты ВКР)
    [Graduate Work.PrjPcb]
2020-06-13 Презентация почти доделана
2020-06-14 Доделан журнал
    [pyvenv.cfg]
2020-06-16 Доделан шаблон страницы Home
2020-06-17 Сделаны заготовки для веб-сервера
